ultrazohm/uz_carrierboard/manufacturing reports/PDF/korrekt_bestueckt.jpg

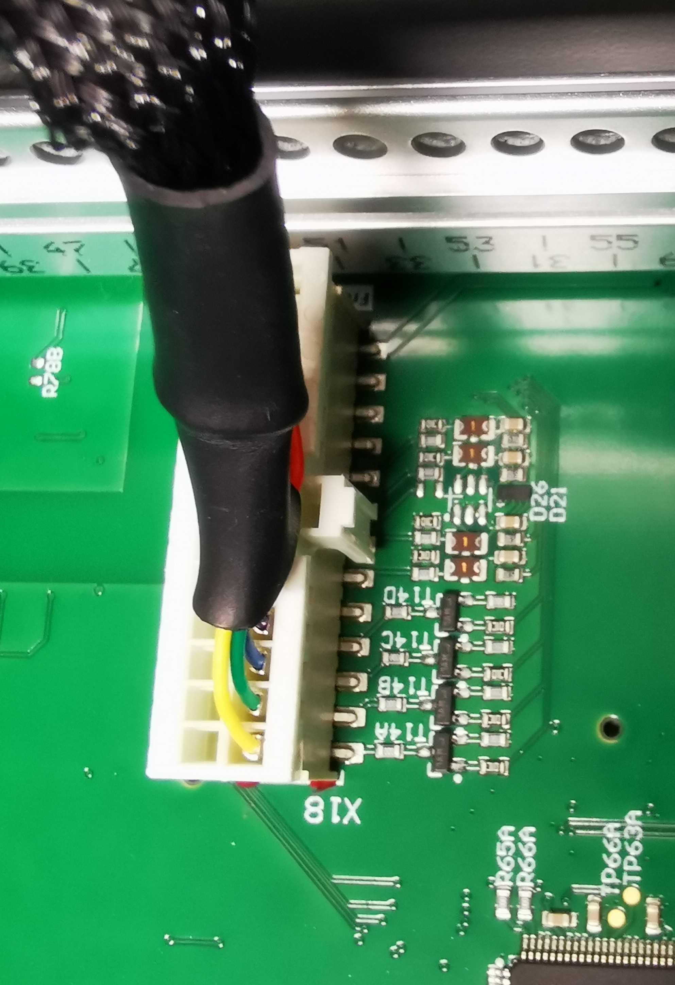
manufacturing reports/PDF/korrekt_bestueckt.jpg
