ultrazohm/uz_carrierboard/bugfix/carrierboardPHYresetfix.docx

Carrier Board PHY reset fix

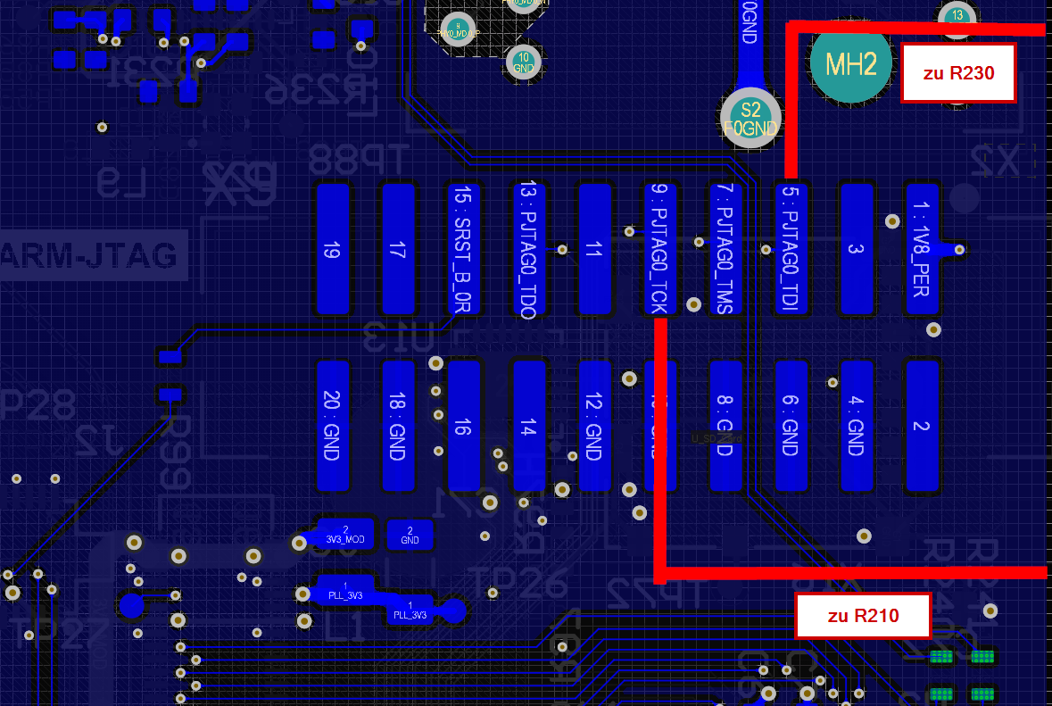
[picture p2: figure]

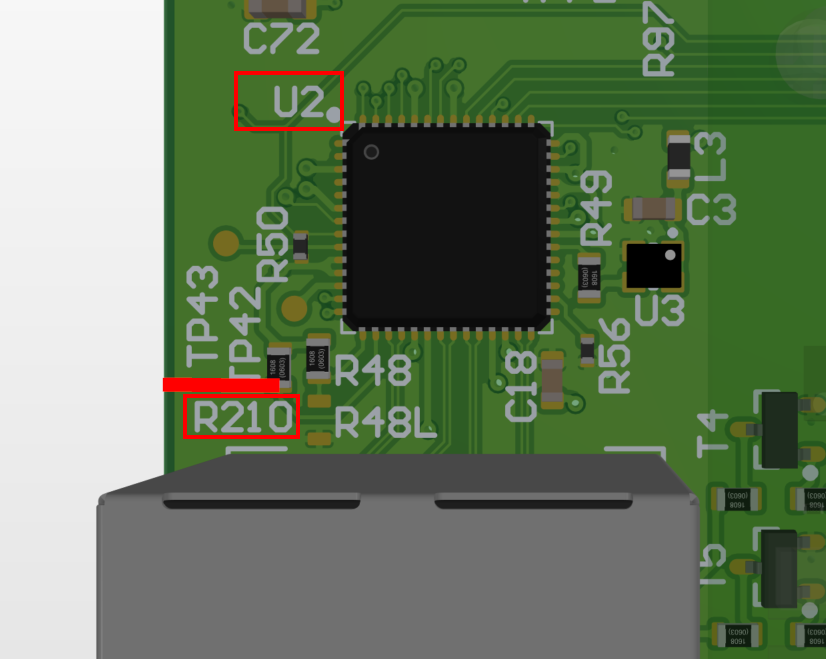
[picture p3: figure]
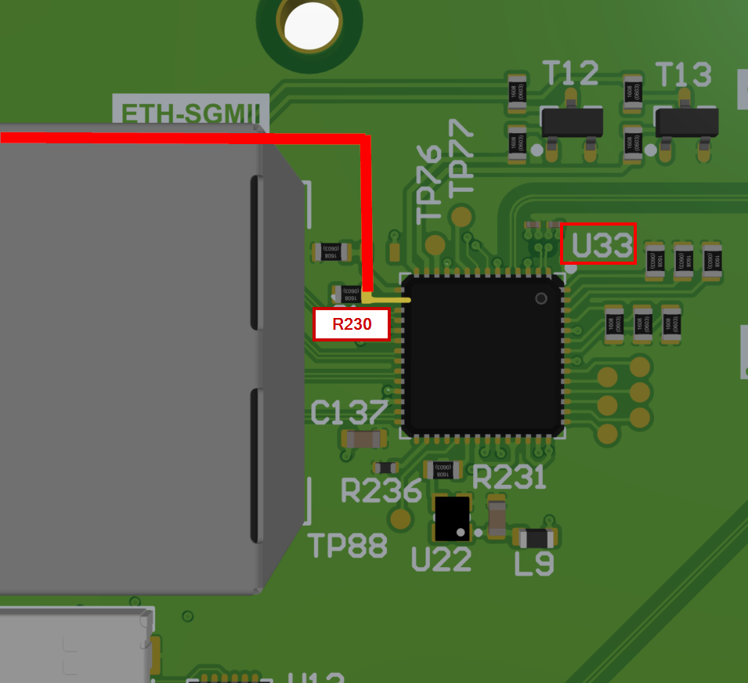
[picture p4: figure]

REPLACE R210 and R230 with 10k !!!
