ultrazohm/uz_carrierboard/Project Outputs for UltraZOhm_CarrierBoard/Rev. 3/BOM/BOM_UltraZOhm_CarrierBoard_3v00_AG1.xls

Sheet: Part List Report
 | Bill of Material |  |  | BOM_Template for Variant [Standard] of Project [UltraZOhm_CarrierBoard.PrjPcb] (No PCB Document Selected)
 | Source Data From: |  | UltraZOhm_CarrierBoard.PrjPcb
 | Project: |  | UltraZOhm_CarrierBoard.PrjPcb
 | Variant: |  | Standard
 | Report Date: |  |  |  | 17.06.2020
 | Print Date: |  |  |  | 2020-06-17
# | Quantity | Comment | Designator | MF | MPN | Voltage | Dielectric | Supplier 1 | Supplier Part Number 1 | Supplier 2 | Supplier Part Number 2 | Supplier 3 | Supplier Part Number 3 | Fabrication Notes
1 | 1 | 22µF | C1 | Multicomp | MC1206X226K160CT | 16V | X5R | Farnell | 2320923
2 | 17 | 470nF | C2, C3, C5, C6, C7, C8, C9, C10, C14, C15, C16, C18, C20, C47, C57, C67, C71 | Kemet | C0603C474K4PACTU | 16V | X5R | Farnell | 2522418
3 | 103 | 100nF | C4, C22A, C22B, C22C, C22D, C22E, C23A, C23B, C23C, C23D, C23E, C24A, C24B, C24C, C24D, C24E, C25A, C25B, C25C, C25D, C25E, C26A, C26B, C26C, C26D, C26E, C27A, C27B, C27C, C27D, C27E, C28A, C28B, C28C, C28D, C28E, C29A, C29B, C29C, C29D, C29E, C30A, C30B, C30C, C30D, C30E, C31A, C31B, C31C, C31D, C31E, C32A, C32B, C32C, C32D, C32E, C33A, C33B, C33C, C33D, C33E, C34A, C34B, C35A, C35B, C38A, C38B, C75, C76, C77, C78, C79, C80, C82, C88, C90, C91, C96, C97, C98, C99, C100, C101, C103, C106A, C106B, C106C, C106D, C106E, C106F, C106G, C106H, C107, C110, C111, C117, C118, C119, C120, C122, C123, C124, C125 | Multicomp | MC0603B104K500CT | 50V | X7R | Farnell | 1759122
4 | 2 | 4.7µF | C11, C13 | Murata | GRT188R61E475KE13D | 25V | X5R | Farnell | 2672159
5 | 1 | 100pF | C12 | Kemet | C1210C101KDGACAUTO | 1000V | C0G / NP0 | Farnell | 2834664
6 | 2 | 10µF | C17, C19 | Murata | GRM188R60J106ME47J | 6.3V | X5R | Farnell | 2611921
7 | 4 | 220nF | C21, C50, C60, C70 | Wuerth Elektronik | 885012206048 | 16V | X7R | Farnell | 2507331 |  |  |  |  | wird beigestellt
8 | 3 | 4.7nF | C36A, C36B, C94 | TDK | C1608C0G1H472J080AA | 50V | C0G / NP0 | Farnell | 1907312
9 | 4 | 1nF | C37A, C37B, C81, C102 | AVX | 06035A102JAT2A | 50V | C0G / NP0 | Farnell | 317202
10 | 4 | 22µF | C39A, C39B, C83, C104 | TDK | C2012X5R1C226M125AC | 16V | X5R | Farnell | 2525135
11 | 4 | 10µF | C40A, C40B, C84, C105 | AVX | 0603ZD106MAT2A | 10V | X5R | Farnell | 1867954
12 | 14 | 10µF | C41, C42, C43, C44, C51, C52, C53, C54, C61, C62, C63, C64, C89, C121 | Murata | GRM21BC8YA106KE11L | 35V | X6S | Farnell | 2611936 | Mouser | 81-GRM21BC8YA106KE1L
13 | 3 | 33nF | C45, C55, C65 | Wuerth Elektronik | 885012206092 | 50V | X7R | Farnell | 2495184 |  |  |  |  | wird beigestellt
14 | 3 | 220µF | C46, C56, C66 | Wuerth Elektronik | 875115350002 | 16V |  | Farnell | 2466695 | Mouser | 710-875115350002 |  |  | wird beigestellt
15 | 6 | 22µF | C48, C49, C58, C59, C68, C69 | Wuerth Elektronik | 885012108018 | 16V | X5R | Mouser | 710-885012108018 |  |  |  |  | wird beigestellt
16 | 3 | 47µF | C72, C92, C93 | Murata | GRM32EC81C476KE15L | 16V | X6S | Farnell | 1907527
17 | 1 | 10µF | C85 | TDK | C2012X7R0J106M125AB | 6.3V |  | Digi-Key | 445-7594-6-ND | Mouser | 810-C2012X7R0J106MAB
18 | 1 | 22µF | C86 | TDK | C2012X7S1A226M125AC | 6.3V |  | Digi-Key | 445-14560-6-ND | Mouser | 810-C2012X7S1A226MAC
19 | 1 | 10nF | C87 | Murata | GRM188R70J103KA01 | 6.3V |  | Digi-Key | 490-9729-1-ND
20 | 1 | 47pF | C95 | Wuerth Elektronik | 885012006055 | 50V | C0G / NP0 | Farnell | 2533852 |  |  |  |  | wird beigestellt
21 | 5 | 100pF | C112, C113, C114, C115, C116 | AVX | 06035A101JAT4A | 50V | C0G / NP0 | Farnell | 499122 | Mouser | 581-06035A101JAT4A, [NoParam] | Digi-Key | 478-10676-1-ND
22 | 6 | 150060RS75000 | D1, D2, D3, D11, D16, D18 | Wuerth Elektronik | 150060RS75000 |  |  | Farnell | 2322071 | Mouser | 710-150060RS75000 | Digi-Key | 732-4978-1-ND | wird beigestellt
23 | 5 | BAT46W | D4A, D4B, D4C, D4D, D4E | Diodes Incorporated | BAT46W-7-F |  |  | Farnell | 1858621 | Mouser | 621-BAT46W-7-F | Digi-Key | BAT46W-7FDICT-ND
24 | 2 | ESDCAN01-2BLY | D5A, D5B | ST Microelectronics | ESDCAN01-2BLY |  |  | Farnell | 2455736 | Mouser | 511-ESDCAN01-2BLY | Digi-Key | 497-15333-1-ND
25 | 8 | BAT20J | D6A, D6B, D7A, D7B, D14, D15, D19, D20 | ST Microelectronics | BAT20JFILM |  |  | Farnell | 1467541
26 | 2 | 150060GS75000 | D10, D25 | Wuerth Elektronik | 150060GS75000 |  |  | Farnell | 2322070 | Mouser | 710-150060GS75000 | Digi-Key | 732-4971-1-ND | wird beigestellt
27 | 5 | 150060BS75000 | D12, D24A, D24B, D24C, D24D | Wuerth Elektronik | 150060BS75000 |  |  | Farnell | 2322069 | Mouser | 710-150060BS75000 | Digi-Key | 732-4966-1-ND | wird beigestellt
28 | 1 | STPS340-Y | D17 | ST Microelectronics | STPS340UY |  |  | Mouser | 511-STPS340UY | Digi-Key | 497-13432-1-ND
29 | 8 | CDSOD323-T03SC | D21A, D21B, D21C, D21D, D21E, D21F, D21G, D21H | Bourns | CDSOD323-T03SC |  |  | Farnell | 2341910 | Mouser | 652-CDSOD323-T03SC | Digi-Key | CDSOD323-T03SCCT-ND
30 | 1 | BZX84C15 | D22 | On Semiconductor | BZX84C15LT1G |  |  | Mouser | 863-BZX84C15LT1G | Digi-Key | BZX84C15LT1GOSCT-ND | Farnell | 1651578
31 | 1 | SMBJ30A, 30V | D23 | Fairchild | SMBJ30A |  |  | Mouser | 512-SMBJ30A
32 | 1 | 5A Fast-Acting Fuse | F1 | Littlefuse | 0154005.DR |  |  | Farnell | 9943668 | Mouser | 576-0154005.DR
33 | 4 | SS5-80-3.50-L-D-K-TR | J1, J2, J3, J4 | SAMTEC | SS5-80-3.50-L-D-K-TR |  |  | Mouser | 200-SS5803.50LDKTR | Digi-Key | SAM15086CT-ND |  |  | wird beigestellt
34 | 1 | 1µH | L1 | Wuerth Elektronik | 74479787210A |  |  | Farnell | 2066866 | Mouser | 710-74479787210A | Digi-Key | 732-3436-1-ND | wird beigestellt
35 | 3 | MPZ1608S221ATA00 | L2, L3, L4 | TDK | MPZ1608S221ATA00 |  |  | Farnell | 1301677 | Mouser | 810-MPZ1608S221ATA00 | Digi-Key | 445-1565-1-ND
36 | 2 | 744235900 | L5A, L5B | Wuerth Elektronik | 744235900 |  |  | Farnell | 2249865 | Mouser | 710-744235900 | Digi-Key | 732-4223-1-ND | wird beigestellt
37 | 5 | 600 Ohm | L6, L7, L8, L9, L11 | Wuerth Elektronik | 742792040 |  |  | Mouser | 710-742792040 | Digi-Key | 732-1620-1-ND |  |  | wird beigestellt
38 | 1 | 1.0µH | L10 | Coilcraft | XFL4020-102MEB |  |  | Mouser | 994-XFL4020-102MEB
39 | 1 | 15µH | L12 | Coilcraft | XAL5050-153MEC |  |  | Mouser | 994-XAL5050-153MEC
40 | 43 | 0R | R1, R15, R16, R26, R27, R48, R65A, R65B, R65C, R65D, R65E, R66A, R66B, R66C, R66D, R66E, R74A, R74B, R74C, R74D, R74E, R99, R132, R168A, R168B, R168C, R168D, R168E, R168F, R168G, R168H, R206, R207, R209, R210, R212, R213, R214, R215, R216, R217, R222, R224 | Multicomp | MCMR06X000 PTL | 75V |  | Farnell | 2073345
41 | 7 | 220 | R2, R4, R6, R52, R53, R142, R147 | Multicomp | MCWR06X2200FTL | 50V |  | Farnell | 2447298
42 | 63 | 10k | R3, R5, R7, R11, R12, R13, R14, R17, R18, R20, R21, R22, R23, R24, R25, R32, R33, R35, R37, R39, R41, R43, R45, R51, R54, R90, R97, R111, R112, R113, R114, R115, R116, R117, R118, R119, R122, R123, R124, R125, R146, R148, R171A, R171B, R171C, R171D, R171E, R171F, R171G, R171H, R175A, R175B, R175C, R175D, R193, R194, R195, R196, R198, R199, R201, R203, R204 | Multicomp | MCWR06X1002FTL | 50V |  | Farnell | 2447230
43 | 2 | 1k | R8, R92 | Yageo, Multicomp | RC0603FR-071KL | 75V |  | Farnell | 9238484
44 | 3 | 100 | R9, R10, R91 | Multicomp | MCWR06X1000FTL | 50V |  | Farnell | 2447227
45 | 12 | 22 | R28A, R28B, R28C, R29A, R29B, R29C, R30A, R30B, R30C, R31A, R31B, R31C | Multicomp | MCWR06X22R0FTL | 50V |  | Farnell | 2447301
46 | 6 | 33 | R49, R71A, R71B, R71C, R71D, R71E | Multicomp | MCWR06X33R0FTL | 50V |  | Farnell | 2447344
47 | 2 | 4k99 | R50, R56 | Multicomp | MCSR06X4991FTL | 75V |  | Farnell | 2074271
48 | 1 | 1M | R55 | ROHM | KTR18EZPF1004 | 500V |  | Farnell | 2802466
49 | 40 | 51 | R57A, R57B, R57C, R57D, R57E, R58A, R58B, R58C, R58D, R58E, R59A, R59B, R59C, R59D, R59E, R60A, R60B, R60C, R60D, R60E, R61A, R61B, R61C, R61D, R61E, R62A, R62B, R62C, R62D, R62E, R63A, R63B, R63C, R63D, R63E, R64A, R64B, R64C, R64D, R64E | Panasonic | EXB-38V510JV |  |  | Mouser | 667-EXB-38V510JV
50 | 34 | 51 | R67A, R67B, R67C, R67D, R67E, R68A, R68B, R68C, R68D, R68E, R69A, R69B, R69C, R69D, R69E, R70A, R70B, R70C, R70D, R70E, R72A, R72B, R72C, R72D, R72E, R73A, R73B, R73C, R73D, R73E, R174A, R174B, R174C, R174D | Multicomp | MCMR06X51R0FTL | 75V |  | Farnell | 2073529
51 | 12 | 62 | R76A, R76B, R77A, R77B, R169A, R169B, R169C, R169D, R169E, R169F, R169G, R169H | Multicomp | MCWR06X62R0FTL | 50V |  | Farnell | 2447415
52 | 2 | 29k4 | R80A, R80B | Vishay | MCWR06X2942FTL | 75V |  | Farnell | 2694813
53 | 4 | 9k31 | R81A, R81B, R127, R164 | Panasonic | ERJ3EKF9311V | 75V |  | Farnell | 2059405
54 | 2 | 4k7 | R82, R86 | Multicomp | MCWR04X4701FTL | 50V |  | Farnell | 2447187
55 | 3 | 1k5 | R83, R87, R93 | Multicomp | MCWR06X1501FTL | 50V |  | Farnell | 2447279
56 | 6 | 47k | R88, R95, R172, R173, R219, R220 | Multicomp Pro | MCWR04X4702FTL | 50V, 50 |  | Farnell | 2447179
57 | 1 | 1k91 | R94 | Panasonic | ERA3ARB1911V | 75V |  | Farnell | 2094529
58 | 1 | 16k | R126 | Vishay | CRCW060316K0FKEA | 75V |  | Farnell | 2138433
59 | 7 | 0R | R128, R129, R130, R131, R133, R136, R139 | Multicomp | MCMR12X000 PTL |  |  | Farnell | 2073874
60 | 1 | 100k | R134 | Vishay | CRCW0603100KFKEA | 75V |  | Farnell | 1469649
61 | 1 | 24k9 | R135 | Vishay | CRCW060324K9FKEA | 75V |  | Farnell | 1469785
62 | 3 | 20k | R137, R140, R143 | Bourns | CR0603-FX-2002ELF | 50V |  | Farnell | 2333523
63 | 1 | 2k | R141 | Multicomp | MCWR06X2001FTL | 50V |  | Farnell | 2447319
64 | 1 | 1k6 | R144 | Panasonic | ERJ3EKF1601V | 75V |  | Farnell | 2303159
65 | 1 | 412k | R145 | Panasonic | ERJ3EKF4123V | 75V |  | Farnell | 2303283
66 | 8 | 6 | R170A, R170B, R170C, R170D, R170E, R170F, R170G, R170H | Bel Fuse | 0ZCK0010FF2G |  |  | Mouser | 530-0ZCK0010FF2G
67 | 4 | 200k | R192, R211, R218, R225 | Multicomp | MCWR06X2003FTL | 50V |  | Farnell | 2447291
68 | 1 | 100 | R197 | Multicomp | MCMR06X51R0FTL | 75V |  | Farnell | 2073347
69 | 3 | DIP Switch | SW1, SW2, SW3 | TE Connectivity | 1571983-5 |  |  | Farnell | 2060778 | Mouser | 506-GDH04STR04 | Digi-Key | 450-1762-1-ND
70 | 12 | MMBT3904 | T1, T2, T3, T4, T5, T6, T7, T9A, T9B, T9C, T9D, T10 | Diodes Incorporated | MMBT3904-7-F |  |  | Farnell | 1773602 | Mouser | 621-MMBT3904-F | Digi-Key | MMBT3904-FDICT-ND
71 | 2 | ATP108-TL-H | T8, T11 | On Semiconductor | ATP108-TL-H |  |  | Mouser | 863-ATP108-TL-H | Farnell | 2774816RL | Digi-Key | ATP108-TL-HOSCT-ND
72 | 1 | SiT8924, 4 MHz | U1 | SiTime | SIT8924AM-12-33N-4.000000G | 3.3V |  | Digi-Key | 1473-1689-1-ND
73 | 1 | 88E1512-A0-NNP2I000 | U2 | Marvell | 88E1512-A0-NNP2I000 |  |  | Mouser | 348-88E1512A0NNP2I00
74 | 1 | SiT8008, 25 MHz | U3 | SiTime | SIT8008BI-73-18S-25.000000G | 1.8V |  | Mouser | 788-8008BI7318S25.G | Digi-Key | SIT8008BI-73-18S-25.000000G
75 | 5 | LA4128V-75TN100E | U4A, U4B, U4C, U4D, U4E | Lattice | LA4128V-75TN100E |  |  | Mouser | 842-LA4128V75TN100E | Digi-Key | LA4128V-75TN100E-ND
76 | 5 | 74AHC1G14GW,125 | U5A, U5B, U5C, U5D, U5E | Nexperia | 74AHC1G14GW,125 |  |  | Digi-Key | 1727-3149-2-ND | Mouser | 771-74AHC1G14GW-G | Farnell | 2336684
77 | 2 | MAX14878 | U6A, U6B | Maxim Integrated | MAX14878AWE+ |  |  | Farnell | 2792798 | Mouser | 700-MAX14878AWE+ | Digi-Key | MAX14878AWE+-ND
78 | 4 | LT1761-BYP | U7A, U7B, U19, U27 | Linear Technology | LT1761ES5-BYP#TRMPBF |  |  | Farnell | 1663782
79 | 4 | 760390015 | U8A, U8B, U20, U28 | Wuerth Elektronik | 760390015 |  |  | Mouser | 710-760390015 | Digi-Key | 732-4459-1-ND |  |  | wird beigestellt
80 | 4 | SN6505BDBVT | U9A, U9B, U21, U29 | Texas Instruments | SN6505BDBVT |  |  | Farnell | 2507108
81 | 3 | 171050601 | U10, U11, U12 | Wuerth Elektronik | 171050601 |  |  | Mouser | 710-171050601 |  |  |  |  | wird beigestellt
82 | 1 | TXS02612RTWR | U13 | Texas Instruments | TXS02612RTWR |  |  | Farnell | 2335617RL | Mouser | 595-TXS02612RTWR | Digi-Key | 296-23869-1-ND
83 | 3 | TXS0108EQPWRQ1 | U14_new, U25_new, U30_new | Texas Instruments | TXS0108EQPWRQ1 |  |  | Mouser | 595-TXS0108EQPWRQ1 | RS | 709-4639 | Digi-Key | 296-23011-1-ND
84 | 2 | 74HC32A | U15, U16 | ON Semiconductor | NLV74HC32ADTR2G |  |  | Mouser | 863-NLV74HC32ADTR2G | Digi-Key | NLV74HC32ADTR2GOSCT-ND
85 | 2 | SN74AVC4T774 | U17, U31 | Texas Instruments | SN74AVC4T774RSVR |  |  | Mouser | 595-SN74AVC4T774RSVR
86 | 1 | ADUM4401 | U18 | Analog Devices | ADUM4401ARWZ |  |  | Mouser | 584-ADUM4401ARWZ-R | Newark | 11R0965
87 | 1 | TPS62097-Q1 | U22 | Texas Instruments | TPS62097QWRGTRQ1 |  |  | Farnell | 2851313 | Mouser | 595-TPS62097QWRGTRQ1 | Digi-Key | 296-48349-1-ND
88 | 1 | TPS54260-Q1 | U23 | Texas Instruments | TPS54260QDGQRQ1 |  |  | Mouser | 595-TPS54260QDGQRQ1 | Digi-Key | 296-28183-1-ND
89 | 2 | ADUM4402 | U24, U26 | Analog Devices | ADUM4402WARWZ |  |  | Mouser | 584-ADUM4402WARWZ
90 | 1 | LMK00105 | U32 | Texas Instruments | LMK00105SQ/NOPB |  |  | Farnell | 2492236 | Mouser | 926-LMK00105SQ/NOPB | Digi-Key | 296-35192-1-ND
91 | 2 | TE0790-Base | X1, X8 | Trenz Electronic | TE0790-02 |  |  | Trenz Electronic | TE0790-02 | Digi-Key | 1686-1023-ND |  |  | zwei-reihige Stiftleisten einlöten
92 | 1 | IPL1-110-02-L-D-K | X3 | SAMTEC | IPL1-110-02-L-D-K |  |  | Farnell | 2779506 | Mouser | 200-IPL111002LDK | Digi-Key | SAM10586-ND | wird beigestellt
93 | 1 | 7499110123 | X4 | Wuerth Elektronik | 7499110123 |  |  | Farnell | 2356117 | Mouser | 710-7499110123 | Digi-Key | 732-4958-ND | wird beigestellt
94 | 3 | HSEC8-140-01-L-DV-A-BL | X5A, X5B, X5C | SAMTEC | HSEC8-140-01-L-DV-A-BL |  |  | Farnell | 2731769 | Mouser | 200-HSEC814001LDVABL | Digi-Key | HSEC8-140-01-L-DV-A-BL-ND | wird beigestellt
95 | 5 | HSEC8-150-01-L-DV-A-BL | X6A, X6B, X6C, X6D, X6E | SAMTEC | HSEC8-150-01-L-DV-A-BL |  |  | Farnell | 2731836 | Mouser | 200-HSEC815001LDVABL | Digi-Key | HSEC8-150-01-L-DV-A-BL-ND | wird beigestellt
96 | 2 | IPL1-104-01-L-S-K | X7A, X7B | SAMTEC | IPL1-104-01-L-S-K |  |  | Farnell | 2856253 | Mouser | 200-IPL110401LSK | Digi-Key | SAM9098-ND | wird beigestellt
97 | 1 | IPL1-106-02-L-D-K | X10 | SAMTEC | IPL1-106-02-L-D-K |  |  | Mouser | 200-IPL110602LDK | Digi-Key | SAM10584-ND |  |  | wird beigestellt
98 | 1 | IPL1-103-01-L-D-K | X12 | SAMTEC | IPL1-103-01-L-D-K |  |  | Farnell | 2856248 | Mouser | 200-IPL110301LDK | Digi-Key | SAM9594-ND | wird beigestellt
99 | 1 | IPL1-108-01-L-D-K | X13 | SAMTEC | IPL1-108-01-L-D-K |  |  | Farnell | 2856261 | Mouser | 200-IPL110801LDK | Digi-Key | SAM10585-ND | wird beigestellt
100 | 1 | IPL1-105-01-L-D-K | X14 | SAMTEC | IPL1-105-01-L-D-K |  |  | Farnell | 2308545 | Mouser | 200-IPL110501LDK | Digi-Key | SAM8825-ND | wird beigestellt
101 | 1 | IPL1-102-01-L-D-K | X15 | SAMTEC | IPL1-102-01-L-D-K |  |  | Farnell | 2667420 | Mouser | 200-IPL110201LDK | Digi-Key | SAM10565-ND | wird beigestellt
102 | 1 | microSD Memory Card Connector with Detec | X16 | Molex | 104031-0811 |  |  | Farnell | 2466891 | Mouser | 538-104031-0811 | Digi-Key | WM6357CT-ND
Total: | 593

Sheet: Project Information
Project Full Path | D:\Work_Altium\UltraZohm_CarrierBoard\UltraZohm_CarrierBoard\UltraZOhm_CarrierBoard.PrjPcb
Project Filename | UltraZOhm_CarrierBoard.PrjPcb
Variant Name | Standard
Data-Source Filename | UltraZOhm_CarrierBoard.PrjPcb
Data-Source Full Path | D:\Work_Altium\UltraZohm_CarrierBoard\UltraZohm_CarrierBoard\UltraZOhm_CarrierBoard.PrjPcb
Title | BOM_Template for Variant [Standard] of Project [UltraZOhm_CarrierBoard.PrjPcb] (No PCB Document Selected)
Total Quantity | 594
Report Time | 11:21
Report Date | 17.06.2020
Report Date & Tine | 17.06.2020 11:21
Output Name | BOM_Template
Output Type | BOM_PartType
Output Generator Name | BOM
Output Generator Description | Bill of Materials
