ultrazohm/uz_carrierboard/manufacturing reports/BOM/BOM_xlsx-S001_fix.xlsx

Designator | AN | Comment | Description
R168 | 21491 | 0R | WID SMD 0R 0,1W 1% TK100 BF 1608 (0603)
R169 | 25938 | 51R | WID SMD 51R 1% 0,1W BF 1608 (0603)
R170 | 28044 | PPTC 0,1A 15V | PTC Resettable Fuse 0.1A 15V SMD 0805
R171 | 21492 | 10K | WID SMD 10K 1% 0,1W BF 1608 (0603)
C106 | 21382 | 100nF | KON 100nF 50V X7R ±10% SMD BF 1608 (0603)
