ultrazohm/uz_carrierboard/manufacturing reports/BOM/BOM_xlsx-S001_additional_costs.xlsx

Beistellungen Carrierboard Rev04
AN | Quantity | Designator | Comment | Preis per Part (ca.) | Preis | Source | Währung | Bestellung
31505 | 2 | U14, U30 | (cs) TXS0108EQPWRQ1 | 5.12 € | 10.24 € | win-source | USD | Order #227370
31971 | 2 | U23A, U23B | (cs) TPS54260DGQR | 1.24 € | 2.48 € | LCSC | USD
31504 | 5 | U17, U25A, U25B, U25C, U31 | (cs) SN74AVC4T774RSVR | 0.56 € | 2.78 € | TI | EUR
31885 | 5 | U4A, U4B, U4C, U4D, U4E | (cs) LC4256V-75TN100C | 23.86 € | 119.30 € | Schukat | EUR
31527 | 3 | U24A, U24B, U24C | (cs) ADUM4402BRWZ | 5.91 € | 17.73 € | RS | EUR
31526 | 1 | U18 | (cs) ADUM4401ARWZ | 5.19 € | 5.19 € | RS | EUR
(handbestückt) | 4 | U9A, U9B, U21, U29 | SN6501DBVR | 8.23 € | 32.92 € | win-source | USD | Order #227370
 | 1 |  | win-source shipping | 5.00 € | 5.00 € | win-source | USD | Order #227370
 |  |  | Summe pro Carrier |  | 195.63 €
 |  |  | Anzahl Carrierboards | 10 | 1956.35 €
