ultrazohm/uz_carrierboard/Simulation/FrontPanel_LEDs/UZ_CB_LEDdrive.asc

D1: LED
Q1: npn; Fairchild_2N3904
R1: res; 100
V1: voltage; 24
V2: voltage; PULSE(0 1.8 10m 1u 1u 50m 0.1)
Named nets: 0
.model Fairchild_2N3904 NPN(Is=6.734f Xti=3 Eg=1.11 Vaf=74.03 Bf=416.4 Ne=1.259 Ise=6.734 Ikf=66.78m Xtb=1.5 Br=.7371 Nc=2 Isc=0 Ikr=0 Rc=1 Cjc=3.638p Mjc=.3085 Vjc=.75 Fc=.5 Cje=4.493p Mje=.2593 Vje=.75 Tr=239.5n Tf=301.2p Itf=.4 Vtf=4 Xtf=2 Rb=10)
.tran 0 70m 0 1u
Driving front panel LEDs
flexible driving 
voltage:
3.3V    or    24V
