ultrazohm/uz_carrierboard/Simulation/PowerSupply_Input_v4/strombegrenzung_cb_dmp4015sss.asc

C1: cap; 100n
C2: cap; 10µ
C3: cap; 500µ
C4: cap; 100n
C5: cap; 10µ
C6: cap; 500µ
D1: diode
R1: res; 47k
R3: res; 47k
R4: res; 47k
R5: res; 47k
R6: res; 10m
R8: res; 47k
R9: res; 47k
R10: res; 47k
R11: res; 47k
R12: res; 10m
Rout_new: res; 5
Rout_old: res; 5
U1: DMP4015SSS
U2: DMP4015SSS
U3: DI_MMSZ5242B
U4: atp108
U5: atp108
V1: voltage; PULSE(0 24 10m 1u 1u 1 2)
V2: voltage; PULSE(0 24 10m 1u 1u 1 2)
Named nets: S1, G, 0, S2, D_U1, S_U1, S_U2, D_U2, G_U2, G_U1, S_U4, D_U4, G_U4, D_U5, S_U5, G_U5
.tran 0 140m 0 1u
.include atp108_rev0.lib
new version: 
(due to usage of Trenz library)
old version:
