ultrazohm/uz_carrierboard/(list of files, drawings)

Other design files:
Analog_Interface.SchDoc
ANL_P54_Buffer.SchDoc
Backpanel.SchDoc
Backpanel_GigIO.SchDoc
Backpanel_SwapMGT4.SchDoc
Block_Diagram.SchDoc
Block_Diagram_Safety.SchDoc
CarrierBoard_TopSheet.SchDoc
DIG_S3C_MultiChannelFunnel.SchDoc
Digital_Interface.SchDoc
ETH-PHY.SchDoc
ETH-PHY_SGMII_TI.SchDoc
Frontpanel.SchDoc
GTH.SchDoc
I2C0_Mux.SchDoc
I2C_Subsystems.SchDoc
isoDebug-Isolation.SchDoc
J1-3xGTHQ_R+B66.SchDoc
J2-1xGTHQ_L+1xGTHCLK+GTRQ+2xGTRCLK+4xPLLCLK+CFG+STAT.SchDoc
J2_RefClkAndRTC.SchDoc
J3-3xGTHCLK+1xPLLCLK+MIO+B47+B48.SchDoc
J4-B64+B65.SchDoc
LevelShiftingExtGPIO.SchDoc
Power_Supply_1.SchDoc
Power_Supply_2.SchDoc
Power_Supply_Input.SchDoc
Rail_Protection_AD.SchDoc
Rail_Protection_BP.SchDoc
Rail_Shutdown_AD.SchDoc
Rev05MergeRedux--External_IO_Protection.SchDoc
Rev05MergeRedux--LED_external.SchDoc
Rev05MergeRedux--LevelShifting_Isolation.SchDoc
S3C.SchDoc
S3C_FrontpanelInterface.SchDoc
S3C_IOs1V8.SchDoc
S3C_IOs3V3.SchDoc
S3C_SplitSPI.SchDoc
S3C_SupplyAndMonitoring.SchDoc
SD_Card.SchDoc
Signal_Distribution.SchDoc
SoM.SchDoc
Switch_External.SchDoc
User_Connectors.SchDoc
UZ_CarrierBoard.PcbDoc
UZ_CarrierBoard.PrjPcb
UZ_CarrierBoard/UZ_CarrierBoard.SCHLIB
