ultrazohm/uz_carrierboard/(commit log)

2019-11-09 First Initialization. UltraZohm_CarrierBoard_2v00 was the final assembled version.
    [Analog_Interface.SchDoc, BOM_UltraZOhm_CarrierBoard_2v00.xls, BOM_UltraZOhm_CarrierBoard_2v00_AG_v1.xlsx, Block_Diagram.SchDoc, Board2Board.SchDoc, CarrierBoard_TopSheet.SchDoc, Collective_FAULT_logic.SchDoc, DiagLEDs.SchDoc]
2020-05-30 removed project outputs from git tracking
    Added gitignore that ignores the History __Preview project logs and project outputs
    [BOM_UltraZOhm_CarrierBoard_2v00.xls, BOM_UltraZOhm_CarrierBoard_2v00_AG_v1.xlsx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]
2020-05-30 Renamed PL_ANL_GPIO_01 to CS_fastADC_02 and CS_fastADC to CS_fastADC_01 on all sheets. Distributed unidirectional and bidirectional level shifiting of U30 and U31 to 2 different sheets
    [Analog_Interface.SchDoc, Board2Board.SchDoc, CarrierBoard_TopSheet.SchDoc, LevelShifting.SchDoc, Signal_Distribution.SchDoc, UltraZOhm_CarrierBoard.PrjPcb, UnidirectionalLevelShifiting.SchDoc]
2020-05-30 Refactored project and removed errors and warning by placing appropriate symbols that match a 100mil grid and by placing no ERC symbols
    [Analog_Interface.SchDoc, BidirectionalLevelShifting.SchDoc, Block_Diagram.SchDoc, Board2Board.SchDoc, Collective_FAULT_logic.SchDoc, Collective_FAULT_logic_new.SchDoc, Digital_Interface.SchDoc, J1.SchDoc]
2020-05-30 Added carrier board and samtec libraries and added new U30 chip in the layout.
    Added termination resistors to outputs of U31 and routet individual traces from U31 to all sockets.
    connected U30 and U31
    Connected 1V8 I2C bus to digital pins
    [Analog_Interface.SchDoc, BidirectionalLevelShifting.SchDoc, CarrierBoard_TopSheet.SchDoc, Signal_Distribution.SchDoc, UltraZOhm_CarrierBoard.PrjPcb, UnidirectionalLevelShifiting.SchDoc]
2020-05-30 Routing of U30 and U31 is finished. Top overlay still needs to be adapted. Fixes #12
    [UltraZOhm_CarrierBoard.PrjPcb]
2020-05-30 Changed description of revision and date on the PCB
    [UltraZOhm_CarrierBoard.PrjPcb]
2020-05-30 Replaced CPLD jumpers by 0 ohm resistors and added U25_new
    [LevelShifting.SchDoc, LevelShiftingExtGPIO.SchDoc, Signal_Distribution.SchDoc, UltraZOhm_CarrierBoard.PrjPcb, isoGPIO.SchDoc]
2020-05-30 Found a bug in LSF symbol definition. Fixed it and rerouted the wrong traces.
    [LevelShifting.SchDoc, LevelShiftingExtGPIO.SchDoc, UltraZOhm_CarrierBoard.PrjPcb]
2020-05-30 Routed U25_old and U25_new. Fixes #14 and #19
    [LevelShiftingExtGPIO.SchDoc]
2020-05-30 Replaced jumpers on CPLD programming traces with 0 ohm resistors. Fixes #4
    [LevelShiftingExtGPIO.SchDoc, Signal_Distribution.SchDoc, UltraZOhm_CarrierBoard.PrjPcb]
2020-05-30 Added input current limitation and GND plane on bottom side. Fixes #15
    [Power_Supply_Input.SchDoc, UltraZOhm_CarrierBoard.PrjPcb]
2020-05-30 Added RC delay circuits to power supplies. Fixes #10
    [BidirectionalLevelShifting.SchDoc, Power_Supply_1.SchDoc, UltraZOhm_CarrierBoard.PrjPcb, UnidirectionalLevelShifiting.SchDoc]
2020-06-02 Updated Top Overlay and assembly variants
    [LevelShifting.SchDoc, LevelShiftingExtGPIO.SchDoc, UltraZOhm_CarrierBoard.PrjPcb]
2020-06-02 Removed traces from under U24 and U26. Fixes #24
2020-06-02 Adapted voltage devider on power supply input. Fixes #10
    Modified RC values at U11 and U12.
    [Power_Supply_1.SchDoc, Power_Supply_Input.SchDoc, UltraZOhm_CarrierBoard.PrjPcb]
2020-06-03 Reworked assembly drawing
    [LevelShifting.SchDoc, LevelShiftingExtGPIO.SchDoc]
2020-06-03 Fixed designators on schematic pages and ground polygons on bottom layer
    [LevelShifting.SchDoc, LevelShiftingExtGPIO.SchDoc, Signal_Distribution.SchDoc, isoGPIO.SchDoc]
2020-06-03 Removed comment on isoCAN page and renamed component classes and rooms for the level shifters in layout
    [isoCAN.SchDoc]
2020-06-03 Added U14_new (TXS instead of LSF level shifter) and changed enable of the level shifters to 3V3 enable
    [LevelShifting.SchDoc, LevelShiftingExtGPIO.SchDoc, LevelShiftingXMOD.SchDoc, UltraZOhm_CarrierBoard.PrjPcb, XMOD.SchDoc]
2020-06-03 Added description of the RC circuuit to PowerSupply1 sheet.
    [Power_Supply_1.SchDoc]
2020-06-03 Changed comment of TXS level shifters to TXS0108EQPWRQ1 which determines the automotiv grade variant.
    [LevelShifting.SchDoc, LevelShiftingExtGPIO.SchDoc, LevelShiftingXMOD.SchDoc]
2020-06-04 Added active BOM doc and added suggestions from Andreas to the layout.
    [Collective_FAULT_logic.SchDoc, J2.SchDoc, LevelShiftingXMOD.SchDoc, Power_Supply_Input.SchDoc, UltraZOhm_CarrierBoard.PrjPcb]
2020-06-05 Added teardrops and reworked assembly drawing.
2020-06-05 Straightend trace PS_3V3_GPIO2 at C120
2020-06-06 Untented R144 and added GND Polygons to isolated interfaces on top layer
    [UltraZOhm_CarrierBoard.PrjPcb]
2020-06-06 Tented some more vias that are next to pads. Chose nominal and not least pitch for U14 U25 and U30. Generated Gerber and drill files
    [BOM_UltraZOhm_CarrierBoard_2v00.xls, BOM_UltraZOhm_CarrierBoard_2v00_AG_v1.xlsx, LevelShifting.SchDoc, LevelShiftingExtGPIO.SchDoc, LevelShiftingXMOD.SchDoc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]
2020-06-06 Removed copper from holes in isolated area and regenerated gerber files
    [UltraZOhm_CarrierBoard.PrjPcb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]
2020-07-14 Fabrication Output files modified Configuration of "DNP" in schematics
    [BOM_UltraZOhm_CarrierBoard_3v00.xls, BOM_UltraZOhm_CarrierBoard_3v00_AG1.xls, Board2Board.SchDoc, LevelShifting.SchDoc, LevelShiftingExtGPIO.SchDoc, LevelShiftingXMOD.SchDoc, Power_Supply_1.SchDoc, Power_Supply_2.SchDoc]
2020-10-22 organized schematics new with signal harness and deleted U25_old and replaced U25_new with a better schematic symbol
    [Analog_Interface.SchDoc, Block_Diagram.SchDoc, Board2Board.SchDoc, CarrierBoard_TopSheet.SchDoc, Collective_FAULT_logic.SchDoc, Collective_FAULT_logic_new.SchDoc, DiagLEDs.SchDoc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]
2020-11-04 Signal busses (all DIG and ANL signals to the sockets) start now indexing by 0
    [Analog_Interface.SchDoc, Board2Board.SchDoc, CarrierBoard_TopSheet.SchDoc, Digital_Interface.SchDoc, Signal_Distribution.SchDoc]
2020-11-09 changed 0R R_0603 resistors to 21491 out of TE.DbLib/R_1608_0603
    [Digital_Interface.SchDoc, ETH-PHY.SchDoc, External_IO_Protection.SchDoc, J1.SchDoc, J2.SchDoc, J4.SchDoc, UltraZOhm_CarrierBoard.PrjPcb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]
2020-11-10 changed another 0R R_0603 resistors (R212 to R224) to 21491
    [Power_Supply_1.SchDoc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]
2020-11-10 changed 0R R_1206 resistors to 25896 out of TE.DbLib/R_3216_1206
    [Power_Supply_2.SchDoc, UltraZOhm_CarrierBoard.PrjPcb]
2020-11-10 changed 10k R_0603 resistors to 21492 out of TE.DbLib/R_1608_0603
    [Collective_FAULT_logic.SchDoc, DiagLEDs.SchDoc, ETH-PHY.SchDoc, External_IO_Protection.SchDoc, J2.SchDoc, Pilot_Line.SchDoc, Power_Supply_1.SchDoc, Power_Supply_2.SchDoc]
2020-11-10 changed SS5-80-3.50-L-D-K-TR sockets to 27219 out of TE.DbLib/CON_B2B
    [J1.SchDoc, J3.SchDoc, J4.SchDoc, UltraZOhm_CarrierBoard.PrjPcb]
2020-11-10 changed SN74AVC4T774 (U31) to 27170 out of TE.DbLib/IF
    [LevelShifting.SchDoc, UltraZOhm_CarrierBoard.PrjPcb]
2020-11-10 changed LT1761-BYP (U7) to 29933 out of TE.DbLib/LREG
    [isoCAN.SchDoc]
2020-11-10 changed U17 (SN74AVC4T774 -> 27170), U19 and U27 (LT1761-BYP -> 29933)
    [UltraZOhm_CarrierBoard.PrjPcb, isoGPIO.SchDoc, isoSPI.SchDoc]
2020-11-10 changed TPS54260-Q1 (U23) to 26100 out of TE.DbLib/A_DCDC
    [Power_Supply_2.SchDoc, UltraZOhm_CarrierBoard.PrjPcb]
2020-11-10 changed WE-DCDC-171050601 (Power_Supply_1.SchDoc) to 26051 out of TE.DbLib/DCDC
    [Power_Supply_1.SchDoc]
2020-11-16 changed 1k R_0603 resistors to 21375 out of TE.DbLib/R_1608_0603 and 16k R_0603 resistors to 22630 out of TE.DbLib/R_1608_0603
    [J2.SchDoc, Power_Supply_1.SchDoc, UltraZOhm_CarrierBoard.PrjPcb, isoGPIO.SchDoc, isoSPI.SchDoc]
2020-11-16 changed 22r R_0603 resistors to 21518 out of TE.DbLib/R_1608_0603, 33r R_0603 resistors to 22430 out of TE.DbLib/R_1608_0603, 220r R_0603 resistors to 22324 out of TE.DbLib/R_1608_0603
    [Analog_Interface.SchDoc, Digital_Interface.SchDoc, ETH-PHY.SchDoc, J2.SchDoc, Power_Supply_2.SchDoc, UltraZOhm_CarrierBoard.PrjPcb]
2020-11-16 changed 20k R_0603 resistors to 26112 out of TE.DbLib/A_R_1608_0603, 47k R_0603 resistors to 22428 out of TE.DbLib/R_1608_0603, 51r R_0603 resistors to 25938 out of TE.DbLib/R_1608_0603, modified lay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
    [DiagLEDs.SchDoc, Digital_Interface.SchDoc, Power_Supply_1.SchDoc, Power_Supply_2.SchDoc, Power_Supply_Input.SchDoc, UltraZOhm_CarrierBoard.PrjPcb]
2020-11-16 changed 10uF C_0603 capacitors to 22918 out of TE.DbLib/C_1608_0603, 10uF C_0805 capacitors to 30144 out of TE.DbLib/C_2012_0805
    [ETH-PHY.SchDoc, Power_Supply_1.SchDoc, Power_Supply_2.SchDoc, Power_Supply_Input.SchDoc, UltraZOhm_CarrierBoard.PrjPcb, isoCAN.SchDoc, isoGPIO.SchDoc, isoSPI.SchDoc]
2020-11-16 changed 100nF C_0603 capacitors to 21382 out of TE.DbLib/C_1608_0603
    [Collective_FAULT_logic.SchDoc, Digital_Interface.SchDoc, ETH-PHY.SchDoc, External_IO_Protection.SchDoc, LevelShifting.SchDoc, LevelShiftingExtGPIO.SchDoc, LevelShiftingXMOD.SchDoc, PickPlace_UltraZOhm_CarrierBoard_4v00.csv]
2020-11-16 changed 1nF C_0603 capacitors to 22523 out of TE.DbLib/C_1608_0603, 4.7nF C_0603 capacitors to 29638 out of TE.DbLib/C_1608_0603, 4.7uF C_0603 capacitors to 29699 out of TE.DbLib/C_1608_0603, 20k R_0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
    [ETH-PHY.SchDoc, Power_Supply_2.SchDoc, UltraZOhm_CarrierBoard.PrjPcb, isoCAN.SchDoc, isoGPIO.SchDoc, isoSPI.SchDoc]
2020-11-16 changed 100r R_0603 resistors to 21380 out of TE.DbLib/R_1608_0603, 1k5 R_0603 resistors to 21514 out of TE.DbLib/R_1608_0603, 1k6 R_0603 (R144) to 26104 out of TE.DbLib/A_R_1608_0603
    [J2.SchDoc, Power_Supply_1.SchDoc, Power_Supply_2.SchDoc, UltraZOhm_CarrierBoard.PrjPcb]
2020-11-17 changed 10nF C_0603_X7R (C87) to 23774 out of TE.DbLib/C_1608_0603, 33nF C_0603 capacitors to 23923 out of TE.DbLib/C_1608_0603, 22uF C_0805 capacitors to 29556 out of TE.DbLib/C_2012_0805, 22uF C_12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
    [J3.SchDoc, Power_Supply_1.SchDoc, Power_Supply_2.SchDoc, UltraZOhm_CarrierBoard.PrjPcb, isoCAN.SchDoc, isoGPIO.SchDoc, isoSPI.SchDoc]
2020-11-17 changed 47uF C_1210 capacitors to 22831 out of TE.DbLib/C_3225_1210, 47pF C_0603 (C95) to 25942 out of TE.DbLib/C_1608_0603, 220nF C_0603 capacitors to 29694 out of TE.DbLib/C_1608_0603, 470nF C_0603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
    [ETH-PHY.SchDoc, Power_Supply_1.SchDoc, Power_Supply_2.SchDoc, SD_Card.SchDoc, UltraZOhm_CarrierBoard.PrjPcb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]
2020-11-17 changed 100pF C_0603 capacitors to 21381 out of TE.DbLib/C_1608_0603, 100pF C_1210 (C12) to 22679 out of TE.DbLib/C_3216_1206, 15uH L_Coilkraft_XAL5050 (L12) to 26235 out of TE.DbLib/A_L_SMD, 1uH L_1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
    [ETH-PHY.SchDoc, J3.SchDoc, Power_Supply_2.SchDoc, UltraZOhm_CarrierBoard.PrjPcb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]
2020-11-17 changed 4k7 R_0603 resistors to 21378 out of TE.DbLib/R_1608_0603, 2k R_0603 (R141) to 26105 out of TE.DbLib/A_R_1608_0603, 1M R_1206 (R55) to 22757 out of TE.DbLib/R_3216_1206, 29k4 R_0603 (R80) to 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
    [ETH-PHY.SchDoc, Power_Supply_1.SchDoc, Power_Supply_2.SchDoc, UltraZOhm_CarrierBoard.PrjPcb, isoCAN.SchDoc]
2020-11-17 changed 600Ohm WE-CBF 742792040 to 24513 out of TE.DbLib/L_2012_0805
    [Power_Supply_1.SchDoc, Power_Supply_2.SchDoc, UltraZOhm_CarrierBoard.PrjPcb]
2020-11-17 changed 88E1512-A0-NNP21000 (U2A,U2B,U2C) to 24652 out of TE.DbLib/IF
    [ETH-PHY.SchDoc]
2020-11-17 changed Testpoint 1mm TP_1mm to 25063 out of TE.DbLib/PCB
    [Analog_Interface.SchDoc, Collective_FAULT_logic.SchDoc, Digital_Interface.SchDoc, ETH-PHY.SchDoc, J2.SchDoc, J3.SchDoc, Pilot_Line.SchDoc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]
2020-11-17 changed TE0790-Base TE0790-JB (X1,X8) to 26694 out of TE.DbLib/BLOCKS, microSD Memory Card Connector with Detec 104031-0811 to 26322 out of TE.DbLib/SOCKET, MMBT3904 NPN-SOT23 transistors to 23806 ou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
    [DiagLEDs.SchDoc, ETH-PHY.SchDoc, J2.SchDoc, Power_Supply_2.SchDoc, SD_Card.SchDoc, UltraZOhm_CarrierBoard.PrjPcb, XMOD.SchDoc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]
2020-11-17 changed TXS02612RTWR (U13) to 24904 out of TE.DbLib/IF, MPZ1608S221ATA00 (L2,L3,L4) to 22718 out of TE.DbLib/L_1608_0603
    [ETH-PHY.SchDoc, SD_Card.SchDoc, UltraZOhm_CarrierBoard.PrjPcb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]
2020-11-18 changed SiT8008 25MHz (U3) SIT8008BI-73-18S-25.000000G to 27228 out of TE.DbLib/CLK, 100k R_0603 (R134) to 22467 out of TE.DbLib/R_1608_0603
    [ETH-PHY.SchDoc, Power_Supply_2.SchDoc, UltraZOhm_CarrierBoard.PrjPcb]
2020-11-18 changed 200k R_0603 resistors to 29980 out of TE.DbLib/R_1608_0603, 412k R_0603 (R145) to 26111 out of TE.DbLib/A_R_1608_0603, BAT46W (D4) to 29999 out of TE.DbLib/DIODE
    [Digital_Interface.SchDoc, LevelShifting.SchDoc, LevelShiftingExtGPIO.SchDoc, LevelShiftingXMOD.SchDoc, Power_Supply_2.SchDoc, UltraZOhm_CarrierBoard.PrjPcb]
2020-11-18 changed STPS340-Y (D17) to 26110 out of TE.DbLib/A_DIODE
    [Power_Supply_2.SchDoc, UltraZOhm_CarrierBoard.PrjPcb]
2020-11-18 changed dnp R_0603 resistors (all from R_1608_0603): 0R to 21491 10k to 21492 100k to 22467 220R to 22324 20k to 22538 200k to 29980 dnf unchangend?
    [Digital_Interface.SchDoc, J2.SchDoc, LevelShifting.SchDoc, LevelShiftingXMOD.SchDoc, Pilot_Line.SchDoc, Power_Supply_1.SchDoc, Power_Supply_2.SchDoc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]
2020-11-18 added excel chart of the components missing in the TrenzLib
    [MissingComponents_CarrierBoard_TrenzLib.xlsx]
2020-11-18 changed DIP Switch SW1,SW2,SW3 (GDH04STR04) to 23417 out of TE.DbLib/PB_SW
    [J2.SchDoc, UltraZOhm_CarrierBoard.PrjPcb]
2020-11-24 added bom with missing components
    [MissingComponents_CarrierBoard_TrenzLib.xlsx]
2020-11-24 missing parts BOM
    [BOM_MissingComponents.xlsx]
2020-11-24 comments nach diskussion mit andreas und simon
    [BOM_MissingComponents.xlsx]
2020-11-24 changed 150060RS75000 LED_RED_0603 to 28261 out of TE.DbLib/LED, 150060GS75000 LED_GREEN_0603 to 28262 out of TE.DbLib/LED, SMBJ30A TVS_Unidir_SMB (D23) to 27476 out of TE.DbLib/DIODE, BAT203 to 2676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
    [BOM_MissingComponents_in_process_Simon.xlsx, J2.SchDoc, Power_Supply_1.SchDoc, Power_Supply_2.SchDoc, Power_Supply_Input.SchDoc, UltraZOhm_CarrierBoard.PrjPcb, isoCAN.SchDoc, isoGPIO.SchDoc]
2020-11-24 changed R_0805_PTC-Fuse (R170A-H) to 28044 out of TE.DbLib/ FUSE, 62R R_0603 resistors to 23134 out of TE.DbLib/R_1005_0402
    [BOM_MissingComponents_in_process_Simon.xlsx, External_IO_Protection.SchDoc, UltraZOhm_CarrierBoard.PrjPcb, isoCAN.SchDoc]
2020-11-24 changed ESDCAN01-BLY (D5) to 27400 out of TE.DbLib/DIODE, ATP108-TL-H ONSC_PMOS_ATP108 (T8,T11) to 27247 out of TE.DbLib/TRANSISTOR
    [BOM_MissingComponents_in_process_Simon.xlsx, Power_Supply_Input.SchDoc, UltraZOhm_CarrierBoard.PrjPcb, isoCAN.SchDoc]
2020-11-24 changed 51R R_0603_Array_4R (EXB-38V5103V) to 22843 out of TE.DbLib/R_NET
    [BOM_MissingComponents_in_process_Simon.xlsx, Digital_Interface.SchDoc, UltraZOhm_CarrierBoard.PrjPcb]
2020-11-24 massenmail an trenz versendet mit allen samtec steckern als SMD
    [BOM_MissingComponents.xlsx, MissingComponents_CarrierBoard_TrenzLib.xlsx, PleaseAdd_Email.xlsx]
2020-11-24 changed 1k91 R_0603 (R94) to 28021 out of TE.DbLib/R_1005_0402
    [BOM_MissingComponents_in_process_Simon.xlsx, Power_Supply_1.SchDoc, Power_Supply_2.SchDoc, Power_Supply_Input.SchDoc]
2020-11-24 changed 74AHC1G146W,125 (U5A,U5B) to 25648 out of TE.DbLib/LOGIC, SiT8924,4MHz (U1) to 29707 out of TE.DbLib/CLK
    [BOM_MissingComponents_in_process_Simon.xlsx, Digital_Interface.SchDoc, UltraZOhm_CarrierBoard.PrjPcb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]
2020-11-24 - changed 7499110123 (X4) to 30726 out of TE.DbLib/CON_IO - adjusted voltage rating of caps for power supply: 220uF (C48,C49,C58,C59,C68,C69,C86) to 23410 out of TE.DbLib/C_2012_0805 47uF (C92,C93) t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
    [BOM_MissingComponents_in_process_Simon.xlsx, ETH-PHY.SchDoc, Power_Supply_1.SchDoc, Power_Supply_2.SchDoc, UltraZOhm_CarrierBoard.PrjPcb]
2020-11-25 adjusted votlage rating of caps for power supply: 10uF 35V to 24685 (10uF 50V) out of TE.DbLib/C_3216_1206 (changed PCB layout of power supply)
    [BOM_MissingComponents_in_process_Simon.xlsx, Power_Supply_1.SchDoc, Power_Supply_2.SchDoc]
2020-11-25 adjusted voltage rating of caps for power supply: 470nF 50V to 23659 (470nF 6.3V but 0402) out of TE.DbLib/C_1005_0402
    [Power_Supply_1.SchDoc, UltraZOhm_CarrierBoard.PrjPcb]
2020-11-27 updated missing parts list, checked some part changes, documents in the xsl
    [BOM_MissingComponents.xlsx, PleaseAdd_Email.xlsx]
2020-12-01 removed 3.2mm mounting holes (MH1-MH6)
    [CarrierBoard_TopSheet.SchDoc, UltraZOhm_CarrierBoard.PrjPcb]
2020-12-01 removed MR connection to the JTAG adapter X8 changed pull-up voltage on R202 to 3.3V added MR testpoint
    [J2.SchDoc, UltraZOhm_CarrierBoard.PrjPcb, XMOD.SchDoc]
2020-12-01 changed SN74LVC1G17DCKR (U5) to 23582 out of TE.DbLib/LOGIC (SN74LVC1G14DRL)
    [Digital_Interface.SchDoc]
2020-12-01 replaced output capacitors of DCDC converters in Power_Supply_1.SchDoc -> replaced 2x22uF and 1x220uF with 3x100uF -> used 23116 out of TE.DbLib/C_3216_1206
    [Power_Supply_1.SchDoc, Power_Supply_2.SchDoc]
2020-12-01 - changed resistors at FB of U12: 10k R_0603 to 25052 out of TE.DbLib/R_1005_0402 1k91 R_0402 to 21514 out of TE.DbLib/R_1608_0603 - changed 470nF of power supply (C47,C57,C67) to 25476 out of TE.DbL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
    [Power_Supply_1.SchDoc, UltraZOhm_CarrierBoard.PrjPcb]
2020-12-05 Used TPS54260 twice to generate both 1.8V rails: - added Power_Supply.SchDoc as a lower-level schematic of Power_Supply_2 - copied component placement in rooms (PCB-layout) - changed polygons (VIN, 5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
    [Power_Supply.SchDoc, Power_Supply_2.SchDoc, UltraZOhm_CarrierBoard.PrjPcb]
2020-12-12 Used TPS54260 twice to generate both 1.8V rails: - took Vin out of the module - renamed lower-level schematic to "Power_Supply_1V8" - integrated the power module twice - without repeat
    [CarrierBoard_TopSheet.SchDoc, Power_Supply.SchDoc, Power_Supply_1V8.SchDoc, Power_Supply_2.SchDoc, UltraZOhm_CarrierBoard.PrjPcb]
2020-12-12 changed IPL1-103-01-L-D-K (X12) to 30760 (IPL1-103-02-L-D-K) out of TE.DbLib/CON_HEADER IPL1-108-01-L-D-K (X13) to 30764 (IPL1-108-02-L-D-K) out of TE.DbLib/CON_HEADER IPL1-105-01-L-D-K (X14) to 3075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
    [Power_Supply_Input.SchDoc, UltraZOhm_CarrierBoard.PrjPcb, isoCAN.SchDoc, isoGPIO.SchDoc, isoSPI.SchDoc]
2020-12-12 changed IPL1-110-02-L-D-K (X3) to 30765 out of TE.DbLib/CON_HEADER, IPL1-106-02-L-D-K (X10) to 30763 out of TE.DbLib/CON_HEADER, HSEC8-140-01-L-DV-A-BL (X5) to 30758 (HTEC8-140-01-L-DV-K) out of TE.D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
    [Analog_Interface.SchDoc, BOM_MissingComponents_in_process_Simon.xlsx, Board2Board.SchDoc, XMOD.SchDoc]
2020-12-12 changed HSEC8-150-01-L-DV-A-BL (X6) to 30757 (HTEC8-150-01-L-DV-K) out of TE.DbLib/CON_B2B
    [BOM_MissingComponents_in_process_Simon.xlsx, Digital_Interface.SchDoc]
2020-12-12 changed ADUM4401 (U18) to 30781 (ISO7741QDWRQ1) out of TE.DbLib/SPECIAL
    [BOM_MissingComponents_in_process_Simon.xlsx, isoSPI.SchDoc]
2020-12-12 changed ADUM4402 (U24,U26) to 30782 (ISO7742QDWRQ1) out of TE.DbLib/SPECIAL
    [BOM_MissingComponents_in_process_Simon.xlsx, isoGPIO.SchDoc]
2020-12-12 changed MAX14878AWE+ (U6) to 30766 out of TE.DbLib/IF, LMK00105SQ/NOPB (U32) to 30774 out of TE.DbLib/CLK
    [BOM_MissingComponents_in_process_Simon.xlsx, isoCAN.SchDoc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]
2020-12-15 changed SN6505BDBVT (U9,U21,U29) to 30768 out of TE.DbLib/DRIVER, 76039015 (U8,U20,U28) to 30767 out of TE.DbLib/L_TRANS
    [BOM_MissingComponents_in_process_Simon.xlsx, isoCAN.SchDoc, isoGPIO.SchDoc, isoSPI.SchDoc]
2020-12-15 changed NLV74HC32ADTR2G (U15,U16) to 30783 out of TE.DbLib/LOGIC
    [BOM_MissingComponents_in_process_Simon.xlsx, Collective_FAULT_logic.SchDoc]
2020-12-15 changed 0154005.DR Littlefuse_154_Fuse (F1) to 30775 out of TE.DbLib/FUSE, 744235900 (L5) to 30776 out of TE.DbLib/L_SMD
    [BOM_MissingComponents_in_process_Simon.xlsx, Power_Supply_Input.SchDoc, UltraZOhm_CarrierBoard.PrjPcb, isoCAN.SchDoc]
2020-12-15 changed 4k99 R_0603 resistors (R50,R56) to 22754 out of TE.DbLib/R_1005_0402, 150060BS75000 (D12,D24) to 30779 out of TE.DbLib/LED
    [BOM_MissingComponents_in_process_Simon.xlsx, DiagLEDs.SchDoc, ETH-PHY.SchDoc, Power_Supply_1.SchDoc]
2020-12-15 changed LA4128V-75TN100E (U4) to 30780 out of TE.DbLib/PROG_LOGIC
    [BOM_MissingComponents_in_process_Simon.xlsx, Digital_Interface.SchDoc, UltraZOhm_CarrierBoard.PrjPcb]
2020-12-15 - changed TXS0108EQPWRQ1 (U14,U25,U30) to 30791 out of TE.DbLib/A_IF - removed R149, R225, R211 (level shifter)
    [BOM_MissingComponents_in_process_Simon.xlsx, LevelShifting.SchDoc, LevelShiftingExtGPIO.SchDoc, LevelShiftingXMOD.SchDoc]
2020-12-15 - changed BZX84C15 (D22) to 29229 (MMSZ5242BT1G) out of TE.DbLib/DIODE - changed C121 10uF 35V to 10uF 50V (1206) - changed C72 47uF 16V to 47uF 6.3V (0805) - changed C1 22uF 25V to 100uF 6.3V (1206)
    [BOM_MissingComponents_in_process_Simon.xlsx, J3.SchDoc, Power_Supply_1.SchDoc, Power_Supply_Input.SchDoc, SD_Card.SchDoc]
2020-12-15 - changed R127, R164 to 26473 (6k98 R_0603) out of TE.DbLib/R_1608_0603 and R126, R161 to 22655 (12k R_0603) out of TE.DbLib/R_1608_0603 to get ratio of 1.7 (3V3) - changed R81 to 26473 (6k98 R_0603)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
    [BOM_MissingComponents_in_process_Simon.xlsx, UltraZOhm_CarrierBoard.PrjPcb, isoCAN.SchDoc, isoGPIO.SchDoc, isoSPI.SchDoc]
2020-12-15 changed CDSOD323-T03SC (8x D21) to twice 29054 (CPDA10R3V3U-HF) out of TE.DbLib/DIODE TVS Array on lower-level schematic and as sheet entry in isoGPIO.SchDoc
    [4_Channel_TVS.SchDoc, BOM_MissingComponents_in_process_Simon.xlsx, External_IO_Protection.SchDoc, UltraZOhm_CarrierBoard.PrjPcb, isoGPIO.SchDoc]
2020-12-16 - changed IPL1-108-02-L-D-K (X11) to 30764 out of TE.DbLib/CON_HEADER - changed R176, R177 (4k99 R_0603) to 22754 out of TE.DbLib/R_1005_0402 - repositioned designators
    [LevelShifting.SchDoc, UltraZOhm_CarrierBoard.PrjPcb, XMOD.SchDoc]
2020-12-16 - removed all teardrops from the design and afterwards added teardrops to all objects again - updated source library from D4 (TE.DbLib/DIODE -> TE.DbLib/A_DIODE)
    [Digital_Interface.SchDoc, UltraZOhm_CarrierBoard.PrjPcb]
2020-12-16 changed all R_Config resistors (0R, 10k, dnp): - replaced dnp 3way jumpers with 30792 out of TE.DbLib/PCB - replaced assembled 3way jumpers with two resistors defined by assembly variant
    [ETH-PHY.SchDoc, J2.SchDoc, LevelShifting.SchDoc, LevelShiftingExtGPIO.SchDoc, LevelShiftingXMOD.SchDoc, Power_Supply_2.SchDoc, SD_Card.SchDoc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]
2020-12-16 changed IPL1-104-01-L-S-K (X7) to 30790 out of TE.DbLib/CON_HEADER
    [UltraZOhm_CarrierBoard.PrjPcb, isoCAN.SchDoc]
2020-12-16 - updated U15, U16 (30783) because of wrong package/footprint - updated all teardrops
    [Collective_FAULT_logic.SchDoc, UltraZOhm_CarrierBoard.PrjPcb]
2020-12-17 simulation files of power supply input protection circuit
2020-12-26 updated documentation of move to trenz lib, after discussion with simon and andreas on 17.12.2020
    [BOM_MissingComponents.xlsx, BOM_MissingComponents_in_process_Simon.xlsx]
2020-12-26 fixed PG_Module port. close Issue #73
    [Power_Supply_2.SchDoc, UltraZOhm_CarrierBoard.PrjPcb]
2020-12-29 added simulation files to PowerSupply_Input_v4
2020-12-30 updated footprints from trenz lib for components J1-J4, U2, U10-U12, D23, X1,3,4,8,10,11,16
    [J2.SchDoc]
2020-12-30 switched to trenz footprints for parts T1-T10, U3, U13, U17, U20, U31, R75 close Issue #70 and close Issue #71
    [Digital_Interface.SchDoc, J2.SchDoc, Power_Supply_2.SchDoc, UltraZOhm_CarrierBoard.PrjPcb]
2020-12-31 cleaned up M13 and M14 layers (assembly top and bottom), also updated all values from trenz lib
    [4_Channel_TVS.SchDoc, Analog_Interface.SchDoc, Board2Board.SchDoc, Collective_FAULT_logic.SchDoc, DiagLEDs.SchDoc, Digital_Interface.SchDoc, ETH-PHY.SchDoc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]
2021-01-01 - reviewed all schematics and fixed several small bugs in the Variants - rerouted entire Power_Supply_Input and adjusted design rules to get desired pin connection - changed R176, R177 to 0603 packag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
    [Board2Board.SchDoc, CarrierBoard_TopSheet.SchDoc, Digital_Interface.SchDoc, ETH-PHY.SchDoc, External_IO_Protection.SchDoc, J1.SchDoc, J2.SchDoc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]
2021-01-01 fixed layer naming and output jobe file to create correct assembly drawing.
2021-01-02 - added and placed fiducials - place R181 - added SATA schematic, harness and and routed it on bottom - implemented 0.3mm clearance rule from trenz and rerouted isolated SPI - ISO CAN and SPI needs s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
    [Board2Board.SchDoc, CarrierBoard_TopSheet.SchDoc, ETH-PHY.SchDoc, J2.SchDoc, J3.SchDoc, LevelShifting.SchDoc, SATA.schdoc, UltraZOhm_CarrierBoard.PrjPcb]
2021-01-03 reshuffeled iso CAN and resolved all clearance violations, expect for the ones for testpoints and 3 pad jumpers pads without assembly.
2021-01-04 bom consolidation
    [External_IO_Protection.SchDoc, LevelShifting.SchDoc, Power_Supply_1.SchDoc, UltraZOhm_CarrierBoard.PrjPcb]
2021-01-04 renamed CAN1,2 to CAN0,1 close Issue #63
    [XMOD.SchDoc]
2021-01-04 added rule of solder mask expansion = 0, as trenz requests.
2021-01-04 updated M15 M16, courtyard layer from PCB library to correctly generate pick&place files
2021-01-04 - teardrops updated - cleaned up drill holes - updated all schematics with the UZ schematic template
    [4_Channel_TVS.SchDoc, Analog_Interface.SchDoc, Block_Diagram.SchDoc, Board2Board.SchDoc, CarrierBoard_TopSheet.SchDoc, Collective_FAULT_logic.SchDoc, DiagLEDs.SchDoc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]
2021-01-07 - removed PS1V8 from JTAG adapter and rerouted it - changed naming convention of MIO pins previously used for USB in J3 - changed naming convention of GT Lanes in J2 - added second SATA connection - 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
    [Board2Board.SchDoc, CarrierBoard_TopSheet.SchDoc, Digital_Interface.SchDoc, J1.SchDoc, J2.SchDoc, J3.SchDoc, SATA.schdoc, UltraZOhm_CarrierBoard.PrjPcb]
2021-01-08 power is shifted to the right
2021-01-10 moved power supplies to the right.
2021-01-11 working on phy sgmii rerouted Vin
    [Board2Board.SchDoc, CarrierBoard_TopSheet.SchDoc, ETH-PHY_SGMII.SchDoc, ETH-PHY_SGMII_TI.SchDoc, J2.SchDoc, LevelShifting.SchDoc, LevelShiftingExtGPIO.SchDoc, LevelShiftingXMOD.SchDoc]
2021-01-11 routing of phy
    [ETH-PHY.SchDoc, ETH-PHY_SGMII.SchDoc, UltraZOhm_CarrierBoard.PrjPcb]
2021-01-13 routed GTH TX0 auf A1 split MDIO from eth_bus
    [Analog_Interface.SchDoc, Board2Board.SchDoc, CarrierBoard_TopSheet.SchDoc, ETH-PHY.SchDoc, ETH-PHY_SGMII.SchDoc, J1.SchDoc, J3.SchDoc, SATA.schdoc]
2021-01-13 GTH schematic to spilt singal in channels 1..3
    [GTH.SchDoc]
2021-01-17 intermediate step for changes requested in issue #80, issue issue #49
    [4_Channel_TVS.SchDoc, Analog_Interface.SchDoc, Block_Diagram.SchDoc, Board2Board.SchDoc, CarrierBoard_TopSheet.SchDoc, DiagLEDs.SchDoc, Digital_Interface.SchDoc, ETH-PHY.SchDoc]
2021-01-19 finished routing front panel connector
    [4_Channel_TVS.SchDoc, Analog_Interface.SchDoc, Board2Board.SchDoc, CarrierBoard_TopSheet.SchDoc, DiagLEDs.SchDoc, Digital_Interface.SchDoc, ETH-PHY.SchDoc, ETH-PHY_SGMII.SchDoc]
2021-01-27 close #42, close #43, close #82, close #83, close #84, close #85, work in progress on issue #6 issue #80
    [4_Channel_TVS.SchDoc, CarrierBoard_TopSheet.SchDoc, ETH-PHY.SchDoc, ETH-PHY_SGMII.SchDoc, External_IO_Protection.SchDoc, FrontPanel.SchDoc, J2.SchDoc, LevelShifting_Isolation.SchDoc]
2021-01-29 added LTspice simulation concerning driving of front panel LEDs
2021-01-29 in the middle of changing the front panel
    [FrontPanel.SchDoc, LED_external.SchDoc, LevelShifting_Isolation.SchDoc, Switch_External.SchDoc, TVS_4Ch_bidirectional.SchDoc, UltraZOhm_CarrierBoard.PrjPcb]
2021-01-31 - added 2 mounting holes for SOM - close issue #6 - shorted pin53 and pin54 on carrier board - close issue #88 - cleaned up drc errors, still some open though
    [4_Channel_TVS_alternative.SchDoc, Analog_Interface.SchDoc, CarrierBoard_TopSheet.SchDoc, External_IO_Protection.SchDoc, FrontPanel.SchDoc, LED_external.SchDoc, LevelShifting_Isolation.SchDoc, TVS_4Ch_bidirectional.SchDoc]
2021-02-01 - updated rules similar to trenz tebf0808 - length matching and keep outs for gtr lanes - repaired drc violations
    [Analog_Interface.SchDoc, ETH-PHY_SGMII.SchDoc, FrontPanel.SchDoc, GTH.SchDoc, J3.SchDoc, UltraZOhm_CarrierBoard.PrjPcb, XMOD.SchDoc]
2021-02-01 - replaced component D8,D9,D13 from Trenz lib - updated schematic and footprints from Trenz lib
    [4_Channel_TVS_alternative.SchDoc, CarrierBoard_TopSheet.SchDoc, ETH-PHY_SGMII.SchDoc, FrontPanel.SchDoc, GTH.SchDoc, J2.SchDoc, LevelShifting.SchDoc, LevelShiftingXMOD.SchDoc]
2021-02-02 pushing only to increase repo size
    [CarrierBoard_TopSheet.SchDoc, UltraZOhm_CarrierBoard.PrjPcb]
2021-02-04 fixed logo and R181, before footprint update from library
    [4_Channel_TVS_alternative.SchDoc, CarrierBoard_TopSheet.SchDoc, ETH-PHY_SGMII.SchDoc, FrontPanel.SchDoc, GTH.SchDoc, J2.SchDoc, LevelShifting.SchDoc, LevelShiftingXMOD.SchDoc]
2021-02-04 updated all footprints from library.
2021-02-08 - added differential vias and stitching caps for mgt lanes, see issue #91 - added optional thevenin termination for mdc on ethernet phy
    [ETH-PHY_SGMII.SchDoc, GTH.SchDoc]
2021-02-09 updated sheet numbering
    [4_Channel_TVS.SchDoc, 4_Channel_TVS_alternative.SchDoc, Analog_Interface.SchDoc, Block_Diagram.SchDoc, Board2Board.SchDoc, CarrierBoard_TopSheet.SchDoc, Collective_FAULT_logic.SchDoc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]
2021-02-12 worked on gth and gtx routing close Issue #91
    [ETH-PHY.SchDoc, ETH-PHY_SGMII.SchDoc, GTH.SchDoc, Power_Supply_1.SchDoc, SATA.schdoc, UltraZOhm_CarrierBoard.PrjPcb, isoSPI.SchDoc]
2021-02-19 - deleted compile masks close issue #99 - deleted comments on trenz part number close issue #100
    [ETH-PHY.SchDoc, SD_Card.SchDoc]
2021-02-19 - added alternative for CLK on CPLD U1 - close issue #96
    [CPLD_Programming.SchDoc]
2021-02-20 - added sata_crossover schematic to cross Rx and Tx, see also issue #94 - turned x17B to route sata_crossover easier - updated sheet count in all schematics
    [4_Channel_TVS.SchDoc, 4_Channel_TVS_alternative.SchDoc, Analog_Interface.SchDoc, Block_Diagram.SchDoc, Board2Board.SchDoc, CarrierBoard_TopSheet.SchDoc, Collective_FAULT_logic.SchDoc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]
2021-02-22 changed naming from SATA to GTR, close issue #94
    [Board2Board.SchDoc, CarrierBoard_TopSheet.SchDoc, GTH.SchDoc, GTR.schdoc, GTR_crossover.schdoc, J1.SchDoc, J2.SchDoc, SATA.schdoc]
2021-02-23 fixed issue with project variants
    [UltraZOhm_CarrierBoard.PrjPcb]
2021-03-01 fixed variants and small comments by andreas (issue #103 and issue #104)
    [ETH-PHY_SGMII.SchDoc, UltraZOhm_CarrierBoard.PrjPcb, isoGPIO.SchDoc]
2021-03-01 based on vadim suggestion, changed variant name with customer supplied parts to "B"
    [UltraZOhm_CarrierBoard.PrjPcb]
2021-03-04 - fixed compiled sheet order - updated components from trenz library
    [4_Channel_TVS.SchDoc, 4_Channel_TVS_alternative.SchDoc, Analog_Interface.SchDoc, Board2Board.SchDoc, CarrierBoard_TopSheet.SchDoc, Collective_FAULT_logic.SchDoc, DiagLEDs.SchDoc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]
2021-03-04 - removed seperate schematic for tvs diodes: close issue #102 - cleaned up routing: close issue #105
    [4_Channel_TVS.SchDoc, 4_Channel_TVS_alternative.SchDoc, FrontPanel.SchDoc, LevelShifting_Isolation.SchDoc, UltraZOhm_CarrierBoard.PrjPcb, isoCAN.SchDoc]
2021-03-04 - updating all footprints from library - close Issue #106 - added teardrops - checked in gerber files to review - added compiled schematic
    [BOM-TEC0194-01.csv, BOM_xlsx.xls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]
2021-03-04 saved entire project
    [UltraZOhm_CarrierBoard.PrjPcb]
2021-03-05 regenerated gerber files, added missing layers and board outline.
    [BOM_xlsx.xls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]
2021-03-06 - adjusted mounting hole template close issue #114 - Top Overlay cosmetic close Issue #110 - fixed Isolation barrier inconsistency: close Issue #112 - regenerated all output files
    [BOM_xlsx.xls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]
2021-03-08 andreas and eyke approved this version of production files, we are ready. :)
    [BOM_xlsx.xls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]
2021-03-11 production files sent to Trenz
    [BOM-TEC0194-01-B.csv, BOM-TEC0194-01.csv, BOM_xlsx-B.xls, BOM_xlsx.xls, PP-TEC0194-01-B.csv, PP-TEC0194-01.csv, UltraZOhm_CarrierBoard.PrjPcb]
2021-04-14 increased spacing around mounting holes and plated the holes as NCAB suggested
    [UltraZOhm_CarrierBoard.PrjPcb]
2021-04-14 added gnd planes on Layer 3 and Layer 4 to equalize copper amount across the pcb
2021-04-14 regenerated output files to fulfill the manufacturing changes of ncab
    [LPC0194-01.GBL, LPC0194-01.GBO, LPC0194-01.GBP, LPC0194-01.GBS, LPC0194-01.GTL, LPC0194-01.GTO, LPC0194-01.GTP, LPC0194-01.GTS]
2021-04-27 Update block diagram and documentation output for UltraZohm website
    [Block_Diagram.SchDoc, ETH-PHY_SGMII.SchDoc, UltraZOhm_CarrierBoard.PrjPcb, XMOD.SchDoc]
2021-08-13 changed R137 to DNP, close Issue #116
    [UltraZOhm_CarrierBoard.PrjPcb]
2021-08-13 added assembly files for TEC0194-01-C, second assembly round of carrier board Rev.04
    [BOM-TEC0194-01-C.csv, BOM_xlsx-C.xls, PP-TEC0194-01-C.csv, UltraZOhm_CarrierBoard.PrjPcb]
2021-08-13 clean up of pdfs for variants added git-lfs attribute
    [BOM_UltraZOhm_CarrierBoard_3v00.xls, BOM_UltraZOhm_CarrierBoard_3v00_AG1.xls, PickPlace_UltraZOhm_CarrierBoard_4v00.csv]
2021-08-13 add pdf for trenz assembly TEC0194-01-C
2021-08-13 UltraZOhm_CarrierBoard.PcbDoc: convert to Git LFS
2021-08-13 UltraZOhm_CarrierBoard.PCBDwf: convert to Git LFS
2021-10-22 created BOM for assembly variant S001, mit neuen Beistellungen
    [BOM-TEC0194-01-S001.csv, BOM_xlsx-S001.xls, PP-TEC0194-01-S001.csv, UltraZOhm_CarrierBoard.PrjPcb, bom_change_s001.xlsx]
2021-10-22 changed to adum parts in trenz library
    [BOM-TEC0194-01-S001.csv, BOM_xlsx-S001.xls, PP-TEC0194-01-S001.csv, UltraZOhm_CarrierBoard.PrjPcb, bom_change_s001.xlsx]
2022-01-12 changes CPLD to to larger version LC4256
    [BOM-TEC0194-01-S001.csv, BOM_xlsx-S001.xls, PP-TEC0194-01-S001.csv, UltraZOhm_CarrierBoard.PrjPcb]
2022-01-30 Testing introduction (End of line) for the Carrier Board
2022-02-02 Change Component TPS54260QDGQRQ1 to TPS54260QDGQR
    [Power_Supply_1V8.SchDoc]
2022-02-02 generated new project output files for Trenz
    [BOM-TEC0194-01-S001.csv, BOM_xlsx-S001.xlsx, PP-TEC0194-01-S001.csv]
2022-02-03 Set SN6505 to DNP for Trenz production
    [BOM-TEC0194-01-S001.csv, BOM_xlsx-S001.xlsx, PP-TEC0194-01-S001.csv, UltraZOhm_CarrierBoard.PrjPcb]
2022-03-14 fixed pick and place file generation in altium 21
    [PP-TEC0194-01-S001.csv, UltraZOhm_CarrierBoard.PcbDoc]
2022-04-07 added quick fix soldering manual for PHY reset issue
2022-08-04 - added pdfs and bom for fixing missing resistors in rev04 -s001 order - added list of beistellungen and approximate costs
    [BOM_xlsx-S001_additional_costs.xlsx, BOM_xlsx-S001_fix.xlsx]
2022-08-04 added costs of jlc order
    [BOM_xlsx-S001_additional_costs.xlsx]
2022-10-26 initial draft of BOM for S002 sent to Trenz
    [BOM-TEC0194-01-S002.csv, UltraZOhm_CarrierBoard.PrjPcb]
2023-01-03 production files for TEC0194-01-S003
    [BOM-TEC0194-01-S002.csv, BOM-TEC0194-01-S003.csv, BOM_xlsx-S003.xlsx, PP-TEC0194-01-S003.csv, UltraZOhm_CarrierBoard.PrjPcb]
2023-01-19 update gitattributes to avoid case sensitive conflicts
2023-01-19 change names to uz_carrier_board - step 1
    [UltraZOhm_CarrierBoard.PrjPcb]
2023-01-19 cleaning repo
    - remove production files
    - rename project to uz_carrierboard
    [BOM_MissingComponents.xlsx, BOM_MissingComponents_in_process_Simon.xlsx, PleaseAdd_Email.xlsx, UZ_CarrierBoard.PrjPcb, UltraZOhm_CarrierBoard.PcbDoc, UltraZOhm_CarrierBoard.PrjPcb]
2024-06-03 unify Ethernet sheets (no actual change)
    [ETH-PHY.SchDoc, ETH-PHY_SGMII.SchDoc]
2024-06-03 add Ethernet resets
    [CarrierBoard_TopSheet.SchDoc, ETH-PHY.SchDoc, ETH-PHY_SGMII.SchDoc]
2024-06-03 move Ethernet connector(s) to dedicated sheet and introduce BASE-T harness
    [ETH-PHY.SchDoc, ETH-PHY_SGMII.SchDoc, ETH-RJ45.SchDoc]
2024-06-03 split Ethernet resets
    [ETH-PHY_SGMII.SchDoc]
2024-06-12 add isoJTAG
    [CarrierBoard_TopSheet.SchDoc, Signal_Distribution.SchDoc, UZ_CarrierBoard.PrjPcb, XMOD.SchDoc, isoJTAG-FTDI.SchDoc, isoJTAG-Isolation.SchDoc, isoJTAG.SchDoc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]
2024-06-13 unify UARTs and I²Cs, and map UART1 to USB-JTAG as well
    [Board2Board.SchDoc, CarrierBoard_TopSheet.SchDoc, J2.SchDoc, J3.SchDoc, Signal_Distribution.SchDoc, XMOD.SchDoc]
2024-06-18 bom für rev05 für winsource anfrage
    [BOM_Rev05_Preliminary_Anfrage_WinSource.xlsx]
2024-06-19 add WS BOM 10x
    [BOM_Rev05_Preliminary_Anfrage_WinSource_10x.xlsx]
2024-06-27 changed J4 Connector
    [J4.SchDoc]
2024-07-01 move on-SoM I²C to PS I²C1
    [Board2Board.SchDoc, CarrierBoard_TopSheet.SchDoc]
2024-07-01 split adapter card/CPLD I²Cs and add mux to PS I²C0
    [CarrierBoard_TopSheet.SchDoc, I2C0_Mux.SchDoc, Signal_Distribution.SchDoc]
2024-07-05 swap ISO674[12]s of isoJTAG to F versions
    [isoJTAG-Isolation.SchDoc]
2024-07-08 first d+u before updating schematics
2024-07-08 [JLC] swap J1,J4 SOM Connectors
    [J1.SchDoc, J4.SchDoc]
2024-07-08 [JLC] update board
    [UZ_CarrierBoard.PcbDoc]
2024-07-08 [JLC] swap AnalogInterface
    [Analog_Interface.SchDoc]
2024-07-08 martin und eyke fixed sn6505 variant bug
    [UZ_CarrierBoard.PcbDoc, UZ_CarrierBoard.PrjPcb]
2024-07-09 [JLC] changed D Slot Connector
    [Digital_Interface.SchDoc]
2024-07-09 [JLC] update project
    [UZ_CarrierBoard.PrjPcb]
2024-07-09 [JLC] changed 0R 0603 on whole project
    [Digital_Interface.SchDoc, ETH-PHY.SchDoc, ETH-PHY_SGMII.SchDoc, External_IO_Protection.SchDoc, FrontPanel.SchDoc, J2.SchDoc, J4.SchDoc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]
2024-07-09 [JLC] swap TE0970 Base (X1)
    [CPLD_Programming.SchDoc]
2024-07-09 [JLC]changed X1 again
    [CPLD_Programming.SchDoc]
2024-07-09 [JLC]changed 10k 0603 (76x)
    [Collective_FAULT_logic.SchDoc, DiagLEDs.SchDoc, Digital_Interface.SchDoc, ETH-PHY.SchDoc, ETH-PHY_SGMII.SchDoc, External_IO_Protection.SchDoc, J2.SchDoc, LED_external.SchDoc]
2024-07-09 [JLC]swap U13 and X16 from SD
    [SD_Card.SchDoc]
2024-07-09 [JLC]swap X8
    [XMOD.SchDoc]
2024-07-09 [JLC]swap U7 isocan
    [isoCAN.SchDoc]
2024-07-09 [JLC]swap R80 isocan
    [isoCAN.SchDoc]
2024-07-09 [JLC]swap U19 IsoSPI
    [isoSPI.SchDoc]
2024-07-09 [JLC]swap U27
    [isoGPIO.SchDoc]
2024-07-09 [JLC] changed T11 and T8
    [Power_Supply_Input.SchDoc]
2024-07-09 correct DMP4015SSS-13
    [Power_Supply_Input.SchDoc]
2024-07-10 [JLC]swapped D22 Zener and D23 TVS to unidirectional
    [Power_Supply_Input.SchDoc]
2024-07-10 [JLC]swapped all 47k 0603 and F1 on Power supply input
    [Power_Supply_1.SchDoc, Power_Supply_Input.SchDoc]
2024-07-10 [JLC] changed to 12V Zener Diode and update board
    [Power_Supply_Input.SchDoc, UZ_CarrierBoard.PcbDoc]
2024-07-10 [JLC] changed power supply u10-12 to ti
    [Power_Supply_1.SchDoc]
2024-07-10 [JLC] changed 100k 0603, 20k 0603,1k5 0603, 4k7 0603, 8k06 0402,100R 0603,1k 0603
    [Power_Supply_1.SchDoc, Power_Supply_1V8.SchDoc]
2024-07-10 [JLC] changed LED D10-12
    [Power_Supply_1.SchDoc]
2024-07-10 [JLC] changed to generic resistors except R145
    [Power_Supply_1V8.SchDoc, Power_Supply_2.SchDoc]
2024-07-10 [JLC] changed D's U's and T's of Powersupply
    [Power_Supply_1V8.SchDoc, Power_Supply_2.SchDoc]
2024-07-10 [JLC]swap X17 Sata to lib
    [GTR.schdoc]
2024-07-10 [JLC]swap R145+R90 (non generic, also mentioned in DbLib)
    [Power_Supply_1.SchDoc, Power_Supply_1V8.SchDoc]
2024-07-10 [JLC] revert changes in SchDoc Sites that shouldn't be changed
    [ETH-PHY.SchDoc, ETH-PHY_SGMII.SchDoc, J2.SchDoc, XMOD.SchDoc]
2024-07-10 [JLC] previous last commit, save whole project
    [UZ_CarrierBoard.PrjPcb]
2024-07-10 [JLC] change schematics back to master, now ready for martin to be merged
    [CPLD_Programming.SchDoc]
2024-07-10 solve footprint errors with Trenz parts
    [UZ_CarrierBoard.PcbDoc, UZ_CarrierBoard.PrjPcb]
2024-07-11 [JLC] test to change parameter from database successfull
    [J1.SchDoc, J4.SchDoc]
2024-07-11 add pull-ups to I²C0 mux
    [I2C0_Mux.SchDoc, UZ_CarrierBoard.PrjPcb]
2024-07-12 move Ethernet LED resistors to connector
    [ETH-PHY.SchDoc, ETH-PHY_SGMII.SchDoc, ETH-RJ45.SchDoc]
2024-07-12 move Ethernet connector(s) to toplevel
    [CarrierBoard_TopSheet.SchDoc, ETH-PHY.SchDoc, ETH-PHY_SGMII.SchDoc]
2024-07-12 move entire SGMII Ethernet and connector of RGMII Ethernet to frontpanel
    [CarrierBoard_TopSheet.SchDoc, ETH-PHY_SGMII.SchDoc, ETH-RJ45.SchDoc, UZ_CarrierBoard.PrjPcb]
2024-07-12 rename harness (from ETH to ETH_RGMII)
    [Board2Board.SchDoc, CarrierBoard_TopSheet.SchDoc, ETH-PHY.SchDoc, J3.SchDoc]
2024-07-12 fix harness sheet entry
    [CarrierBoard_TopSheet.SchDoc]
2024-07-19 add outputjob file for JLC production
    [UZ_CarrierBoard.PrjPcb]
2024-07-21 lock GTR.Harness for connector-free net naming and add frontpanel connector (with preliminary pinning from uz_frontpanel_main)
    [Board2Board.SchDoc, CarrierBoard_TopSheet.SchDoc, GTR.schdoc, GTR_crossover.schdoc, J2.SchDoc, UZ_CarrierBoard.PrjPcb, XMOD.SchDoc, XMOD_Frontpanel.SchDoc]
2024-07-22 rotate (180°) D17[AB], rotate (180°) and move (2.515/-0.977+0.6) D22, and rotate (-90°) R90; fix of design rules(?) w.r.t. mounting hole clearance and repour still pending...
    [UZ_CarrierBoard.PcbDoc]
2024-07-31 fix design rules; repour still pending...
    [UZ_CarrierBoard.PcbDoc]
2024-07-31 t+g+a -> back at 152 drc errors (and therewith in line with master aka 67b56a421f380ed79787d4d26142fcd42fc96b30)
    [UZ_CarrierBoard.PcbDoc]
2024-08-02 [JLC] changed capacitors (to both generic and JLC-selected ones)
    [Collective_FAULT_logic.SchDoc, Digital_Interface.SchDoc, External_IO_Protection.SchDoc, GTH.SchDoc, GTR.schdoc, LevelShifting.SchDoc, Power_Supply_1.SchDoc, Power_Supply_1V8.SchDoc]
2024-08-02 [JLC] update board (incl. t+g+a)
    [UZ_CarrierBoard.PcbDoc]
2024-08-03 prepare for merge with Rev05 (part 1/3: remove parts)
    [Collective_FAULT_logic.SchDoc, FrontPanel.SchDoc, LevelShifting.SchDoc, LevelShiftingXMOD.SchDoc, Rev05MergeRedux--External_IO_Protection.SchDoc, Rev05MergeRedux--LED_external.SchDoc, Rev05MergeRedux--LevelShifting_Isolation.SchDoc, UZ_CarrierBoard.PrjPcb]
2024-08-03 prepare for merge with Rev05 (part 2/3: remove rests)
    [UZ_CarrierBoard.PcbDoc]
2024-08-03 prepare for merge with Rev05 (part 3/3: update polys)
    [UZ_CarrierBoard.PcbDoc]
2024-08-04 fix and update variant Rev05, others unchecked (except for R210 ;))
    [ETH-PHY.SchDoc, I2C0_Mux.SchDoc, UZ_CarrierBoard.PrjPcb]
2024-08-04 bump revision and date
    [UZ_CarrierBoard.PrjPcb]
2024-08-06 switch from CPLD to new Lattice MachXO2 as D-Slot-Controller; set DNPs in variant for EEPROM addressing pull-downs
    [Digital_Interface.SchDoc, UZ_CarrierBoard.PrjPcb]
2024-08-06 add system connections (SPI and DIOs) to D-slot controllers; update I²C ports to Andi's changes (all other ports still pending)
    [CarrierBoard_TopSheet.SchDoc, DIG_S3C_MultiChannelFunnel.SchDoc, S3C.SchDoc, Signal_Distribution.SchDoc, UZ_CarrierBoard.PrjPcb]
2024-08-07 add sheet entry ports of Digital_Interface.SchDoc
    [Digital_Interface.SchDoc, Signal_Distribution.SchDoc]
2024-08-14 add stock for parts
    [BOM_Rev05_Stock_30x.xlsx, BOM_Rev05_WinSource_30x.xlsx]
2024-08-14 adapt to new layer stack (profiles still OOD) and reroute D-slots signals while preparing for MGTs
    [UZ_CarrierBoard.PcbDoc]
2024-08-14 remove Rev04 PS-GTR circuitry (SGMII Ethernet, 2x SATA) while preparing for MGTs
    [UZ_CarrierBoard.PcbDoc]
2024-08-15 reassign layers, make L7 a ground plane/poly and adapt VCCO routing while preparing for MGTs
    [UZ_CarrierBoard.PcbDoc]
2024-08-16 push queued schematic changes to board and position X1 (towards frontpanel_main)
    [CarrierBoard_TopSheet.SchDoc, I2C0_Mux.SchDoc, J3.SchDoc, UZ_CarrierBoard.PcbDoc, UZ_CarrierBoard.PrjPcb, XMOD.SchDoc, XMOD_Frontpanel.SchDoc, isoJTAG-FTDI.SchDoc]
2024-08-19 make Power_Supply_1V8 parametric (and rename to Power_Supply_TPS54260) while adding S³C supply, make unprotected supply input available and add basic monitoring
    [CarrierBoard_TopSheet.SchDoc, Power_Supply_1V8.SchDoc, Power_Supply_2.SchDoc, Power_Supply_Input.SchDoc, Power_Supply_TPS54260.SchDoc, S3C.SchDoc, S3C_SupplyAndMonitoring.SchDoc, UZ_CarrierBoard.PrjPcb]
2024-08-20 draw safety block diagram
    [Block_Diagram_Safety.SchDoc, UZ_CarrierBoard.PrjPcb]
2024-08-21 document all Power_Supply_TPS54260 instances
    [Power_Supply_2.SchDoc, S3C_SupplyAndMonitoring.SchDoc]
2024-08-22 add further monitoring sources
    [S3C_SupplyAndMonitoring.SchDoc]
2024-08-23 set Slot Controller resistor-array designator to Rev04 compatible designators; change Testpoint lib; update safety diagram
    [Block_Diagram_Safety.SchDoc, Digital_Interface.SchDoc, UZ_CarrierBoard.PrjPcb]
2024-08-23 fix "multiple top level documents" error (caused by Block_Diagram_Safety.SchDoc)
    [CarrierBoard_TopSheet.SchDoc]
2024-08-23 generalize power monitoring of VIN
    [Power_Monitoring_TPS3803.SchDoc, S3C.SchDoc, S3C_SupplyAndMonitoring.SchDoc, UZ_CarrierBoard.PrjPcb]
2024-08-26 add S³C
    [S3C.SchDoc, S3C_IOs1V8.SchDoc, S3C_IOs3V3.SchDoc, UZ_CarrierBoard.PrjPcb]
2024-08-26 remove former external CPLD clock and distribution chip
    [Signal_Distribution.SchDoc, UZ_CarrierBoard.PcbDoc, UZ_CarrierBoard.PrjPcb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]
2024-08-26 placement of System Controller surrounding parts
    [Digital_Interface.SchDoc, UZ_CarrierBoard.PcbDoc]
2024-08-27 add JTAG multiplexing
    [CarrierBoard_TopSheet.SchDoc, S3C.SchDoc, S3C_IOs3V3.SchDoc, S3C_MuxJTAG.SchDoc, UZ_CarrierBoard.PrjPcb]
2024-08-28 placement of System Controller surrounding parts [commit identical to AG's currently-missing 06856e03010c32b7e662252b030a39b178ec9ba5]
    [Digital_Interface.SchDoc, UZ_CarrierBoard.PcbDoc]
2024-08-28 update S³C-to-D connctions based on Block_Diagram_Safety and extend concept docs
    [Block_Diagram_Safety.SchDoc, DIG_S3C_MultiChannelFunnel.SchDoc, S3C.SchDoc, Signal_Distribution.SchDoc]
2024-08-28 small fixes (sheet template, project includes)
    [Block_Diagram_Safety.SchDoc]
2024-08-31 route isoUSB (JTAGs and UARTs), simplify power distribution (below SoM) and make room on L4/5 for primarily-horizontal/vertical (below-SoM) routing
    [UZ_CarrierBoard.PcbDoc, isoJTAG-Isolation.SchDoc]
2024-09-01 rewire GND @ J1 (making room on L8 for horizontal below-SoM routing) and prepare for B64_T[0-3] breakout (to S³C)
    [UZ_CarrierBoard.PcbDoc]
2024-09-02 [JLC] changed oscillator of RGMII Ethernet
    [ETH-PHY.SchDoc]
2024-09-05 insert CPLD JTAG harness
    [Digital_Interface.SchDoc, Signal_Distribution.SchDoc]
2024-09-05 remove PILOT_LINE chain through digital sockets
    [Pilot_Line.SchDoc, Signal_Distribution.SchDoc, UZ_CarrierBoard.PcbDoc, UZ_CarrierBoard.PrjPcb]
2024-09-05 Add high-side switch for VIN supply of adapter cards
    [Power_Protection_DigitalAndAnalogInterfaces.SchDoc]
2024-09-05 placement and routing of slot high-side switch
    [Digital_Interface.SchDoc, Power_Protection_DigitalAndAnalogInterfaces.SchDoc, Signal_Distribution.SchDoc, UZ_CarrierBoard.PcbDoc, UZ_CarrierBoard.PrjPcb]
2024-09-06 local routing D-Slot controller
    [Digital_Interface.SchDoc, UZ_CarrierBoard.PcbDoc]
2024-09-09 D-Slot controller pinout planning
    [UZ_CarrierBoard.PcbDoc]
2024-09-10 rearrange FPGA pins to D-Slot controller
    [Digital_Interface.SchDoc, UZ_CarrierBoard.PcbDoc]
2024-09-10 finish local routing of D-Slot controller D1
    [Digital_Interface.SchDoc, UZ_CarrierBoard.PcbDoc]
2024-09-10 transfer routing to D2 - D5 via "copy room formats" feature
    [Digital_Interface.SchDoc, UZ_CarrierBoard.PcbDoc]
2024-09-10 routing of VIN high-side switch protection at all D-Slots
    [Digital_Interface.SchDoc, UZ_CarrierBoard.PcbDoc, UZ_CarrierBoard.PrjPcb]
2024-09-10 remove already-disabled schematic sheets (isoCAN/GPIO/SPI, level shifting and old FP), remap MIOs, add CPLD-SPI logic, I²C subsystems, level shifting for the new frontpanel's user interface, thermal 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
    [Board2Board.SchDoc, CarrierBoard_TopSheet.SchDoc, DiagLEDs.SchDoc, ETH-PHY.SchDoc, FrontPanel.SchDoc, I2C0_Mux.SchDoc, I2C_Subsystems.SchDoc, J2.SchDoc]
2024-09-10 clean up nets and reactivate air wires
    [UZ_CarrierBoard.PcbDoc]
2024-09-12 update parts to pull database fixes
    [ETH-PHY.SchDoc, Power_Supply_TPS54260.SchDoc]
2024-09-12 add high-side switch to A slots as well (complements 5327beea1afd211846eae97bf5e8b169325dbc78, "schematically")
    [Analog_Interface.SchDoc, Signal_Distribution.SchDoc]
2024-09-12 optimize towards BoM
    [Analog_Interface.SchDoc, Collective_FAULT_logic.SchDoc, J1.SchDoc, J2.SchDoc, J3.SchDoc, Power_Supply_1.SchDoc, SD_Card.SchDoc]
2024-09-12 update parts to pull metadata from database, replace J2 and J3, set non-part and non-DB components "no BoM", set X15 "DNP" and fix incorrect variant definitions for U4[A-E] (from 544edd64bebbccc5473d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
    [Analog_Interface.SchDoc, CarrierBoard_TopSheet.SchDoc, J1.SchDoc, J2.SchDoc, J3.SchDoc, J4.SchDoc, Power_Supply_Input.SchDoc, UZ_CarrierBoard.PrjPcb]
2024-09-12 resolve DNP-FIXMEs (1/2)
    [J2.SchDoc, Power_Protection_DigitalAndAnalogInterfaces.SchDoc, UZ_CarrierBoard.PrjPcb]
2024-09-13 fix debug LEDs
    [DiagLEDs.SchDoc]
2024-09-13 match symbol rotation to board netlist while preparing for d+u
    [ETH-PHY.SchDoc, Power_Supply_1.SchDoc, Power_Supply_TPS54260.SchDoc, SD_Card.SchDoc]
2024-09-13 push post-merge part updates to board (partial d+u), fix resulting orientation and clearance issues, and manually swap the (nine) non-matching packages (X14, D1-3, D24[A-D] and D25)
    [UZ_CarrierBoard.PcbDoc]
2024-09-16 add remaining schematic changes (pending from pre merge)
    [Analog_Interface.SchDoc, Board2Board.SchDoc, CarrierBoard_TopSheet.SchDoc, Collective_FAULT_logic.SchDoc, Digital_Interface.SchDoc, J2.SchDoc, J3.SchDoc, LevelShifting.SchDoc]
2024-09-16 optimize S3C supply
    [Power_Supply_2.SchDoc, Power_Supply_Input.SchDoc, S3C_SupplyAndMonitoring.SchDoc]
2024-09-16 swap and move X14, move U2 et al., update D100 parametrization and add BP markers (all while preparing for d+u)
    [UZ_CarrierBoard.PcbDoc]
2024-09-16 t+a (while preparing for d+u)
    [DiagLEDs.SchDoc, I2C_Subsystems.SchDoc, J2_RefClkAndRTC.SchDoc, Power_Monitoring_TPS3803.SchDoc, Power_Supply_1.SchDoc, Power_Supply_Input.SchDoc, S3C.SchDoc, S3C_IOs1V8.SchDoc]
2024-09-16 resolve DNP-FIXMEs (2/2)
    [Power_Supply_Input.SchDoc, S3C_IOs1V8.SchDoc, Signal_Distribution.SchDoc, UZ_CarrierBoard.PrjPcb, XMOD_Thermal.SchDoc]
2024-09-29 S³C and frontpanel connected, board routed except for D slot ground
    Details:
    - reroute SoM configurations signals
    - route GTRs of SoM
    - length-match GTRs
    - optimize RGMII
    - move 1V8_PER
    - move SD card
    - add I²C subsystem
    - add voltage monitoring
    - add labels for SoM cfg. DIPs (bottom overlay)
    - route frontpanel-driven GTR refclock (cf. MZ)
    - add RTC battery (w/ LDO)
    - route CPLD communication
    - route Ethernet MDI to FP
    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
    [Analog_Interface.SchDoc, Board2Board.SchDoc, CarrierBoard_TopSheet.SchDoc, Digital_Interface.SchDoc, ETH-PHY.SchDoc, GTH.SchDoc, I2C_Subsystems.SchDoc, J2_RefClkAndRTC.SchDoc]
2024-09-30 fix D-slot CPLD pins (14+16) and route D slot (CPLD) ground
    [UZ_CarrierBoard.PcbDoc]
2024-09-30 fix 965 compiler errors ("Duplicate Net Names Wire [...]") caused by pin-incompatible component overrides for U4[A-E] in variants S00[1-3]
    [UZ_CarrierBoard.PrjPcb]
2024-09-30 unify via tenting based on feedback from JLC
    [UZ_CarrierBoard.PcbDoc]
2024-09-30 enable generation of Gerber Board Profile (suffix .GM)
2024-10-05 fix component/database issues (missing solder mask definitions for C126-137 and incorrect footprints for D4, U28A and U28B)
    [J2_RefClkAndRTC.SchDoc, Power_Monitoring_TPS3803.SchDoc, S3C_SupplyAndMonitoring.SchDoc, UZ_CarrierBoard.PcbDoc]
2024-10-05 move S1, R15, R128, R129 and R136 (and reroute accordingly)
    [UZ_CarrierBoard.PcbDoc, UZ_CarrierBoard.PrjPcb]
2024-10-05 remove shared signals of analog slots and add legacy "P54" ADC clock via S³C
    [Analog_Interface.SchDoc, S3C_IOs3V3.SchDoc, Signal_Distribution.SchDoc, UZ_CarrierBoard.PcbDoc]
2024-10-11 import @EykeAufderheide's part mapping for UZgen workflow (columns E and G only)
    [BOM_JLC-UZ_CarrierBoard(Rev05)-UZgenPartsMap.csv]
2024-10-11 fix and resolve part map (change voltage of C_0603_2.2nF)
    [BOM_JLC-UZ_CarrierBoard(Rev05)-UZgenPartsMap.csv]
2024-10-11 resolve generic LEDs to finalize part map (as used in production)
    [BOM_JLC-UZ_CarrierBoard(Rev05)-UZgenPartsMap.csv]
2024-10-14 fix age-old "unconnected line" errors (caused by wires in block diagram)
    [Block_Diagram.SchDoc]
2024-10-14 update block diagram to modified signal routing and newly added features
    [Block_Diagram.SchDoc]
2024-10-15 extend block diagram
    [Block_Diagram_Safety.SchDoc]
2024-10-16 moved lower mounting holes +0.25mm y, set distance between upper and lower mounting holes to 122.5mm y, moved X1 +0.24mm y and reconnected all wires, also moved some nearby Vias accordingly. Hopefull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
    [UZ_CarrierBoard.PcbDoc]
2024-10-20 move X1-surrounding vias, tracks, cut-outs and parts (sync to 6fcc8a67c1389249343ba55ca46ab5026fe4fefa), reassign and move S1, move Ethernet (while preparing for GTH breakout), add GND vias, unify ad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
    [Analog_Interface.SchDoc, Digital_Interface.SchDoc, S3C.SchDoc, S3C_IOs1V8.SchDoc, S3C_IOs3V3.SchDoc, Signal_Distribution.SchDoc, UZ_CarrierBoard.PcbDoc, UZ_CarrierBoard.PrjPcb]
2024-12-06 route shared fault of A PPs to S³C, add 12V supply for fan outputs, rename PP instances, add backpanels for external GTH connectivity, add (x1) GTH connectivity to slots A[2-3] as well, replace exist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
    [Analog_Interface.SchDoc, BOM_JLC-UZ_CarrierBoard(Rev05)-UZgenPartsMap.csv, BOM_JLC-UZ_CarrierBoard(Rev05)-UZgenResolved.csv, Backpanel.SchDoc, Backpanel_GigIO.SchDoc, Backpanel_SwapMGT4.SchDoc, Block_Diagram.SchDoc, Board2Board.SchDoc]
2024-12-09 rename sheets
    [Analog_Interface.SchDoc, Backpanel_GigIO.SchDoc, Block_Diagram.SchDoc, Board2Board.SchDoc, CarrierBoard_TopSheet.SchDoc, Digital_Interface.SchDoc, ETH-PHY.SchDoc, Frontpanel.SchDoc]
2024-12-09 assign sheet metadata
    [Backpanel.SchDoc, Backpanel_GigIO.SchDoc, Backpanel_SwapMGT4.SchDoc, Block_Diagram_Safety.SchDoc, DIG_S3C_MultiChannelFunnel.SchDoc, Frontpanel.SchDoc, I2C0_Mux.SchDoc, I2C_Subsystems.SchDoc]
2024-12-09 update sheet metadata (after renumbering)
    [Analog_Interface.SchDoc, Backpanel.SchDoc, Backpanel_GigIO.SchDoc, Backpanel_SwapMGT4.SchDoc, Block_Diagram.SchDoc, Block_Diagram_Safety.SchDoc, CarrierBoard_TopSheet.SchDoc, DIG_S3C_MultiChannelFunnel.SchDoc]
2024-12-15 final schematic (PDF)
    [BOM_Rev05_Preliminary_Anfrage_WinSource.xlsx, BOM_Rev05_Preliminary_Anfrage_WinSource_10x.xlsx, BOM_Rev05_Stock_30x.xlsx, BOM_Rev05_WinSource_30x.xlsx, UZ_CarrierBoard.PrjPcb]
2024-12-15 remove old/invalid and rename current variant(s)
    [BOM_JLC-UZ_CarrierBoard(Rev05Batch00)-UZgenPartsMap.csv, BOM_JLC-UZ_CarrierBoard(Rev05Batch00)-UZgenResolved.csv, UZ_CarrierBoard.PrjPcb]
2025-02-26 parameterize R145, externalize R203[ABD] and remove R203C
    [Power_Supply_2.SchDoc, Power_Supply_TPS54260.SchDoc, S3C_SupplyAndMonitoring.SchDoc, Thermal.SchDoc, UZ_CarrierBoard.PrjPcb]
2025-03-12 move Power_Supply_TPS54260.SchDoc to altium_subsheets: (9db13111d212a5d2e7638154d522cda6653ae0aa)
    [Power_Supply_TPS54260.SchDoc, UZ_CarrierBoard.PrjPcb]
2025-03-14 rename sheet( instance)s
    [UZ_CarrierBoard.PrjPcb, User_Connectors.SchDoc, isoDebug-FTDI.SchDoc, isoDebug-Isolation.SchDoc, isoDebug.SchDoc, isoJTAG.SchDoc]
2025-03-14 rename isoDebug supply nets
    [Frontpanel.SchDoc, isoDebug-FTDI.SchDoc, isoDebug-Isolation.SchDoc, isoDebug.SchDoc]
2025-03-19 rename parts while preparing for (partial) move to altium_subsheets
    [S3C_MuxJTAG.SchDoc, Thermal.SchDoc, UZ_CarrierBoard.PrjPcb, isoDebug-FTDI.SchDoc, isoDebug-Isolation.SchDoc, isoDebug.SchDoc]
2025-03-20 add (and use) power ports while preparing for move to altium_subsheets
    [S3C.SchDoc, S3C_MuxJTAG.SchDoc, Thermal.SchDoc, User_Connectors.SchDoc]
2025-03-20 optimize BoM (Cs)
    [ETH-PHY.SchDoc, J2_RefClkAndRTC.SchDoc, S3C_IOs1V8.SchDoc, Thermal.SchDoc, isoDebug-FTDI.SchDoc, isoDebug.SchDoc]
2025-03-21 optimize BoM (Rs)
    [ETH-PHY.SchDoc, Power_Supply_1.SchDoc, S3C_IOs1V8.SchDoc, Signal_Distribution.SchDoc, UZ_CarrierBoard.PrjPcb, isoDebug-FTDI.SchDoc, isoDebug-Isolation.SchDoc]
2025-03-21 rename nets (supply rails of Ethernet PHY)
    [ETH-PHY.SchDoc]
2025-03-21 move Power_Monitoring_TPS3803.SchDoc, S3C_MuxJTAG.SchDoc, Thermal.SchDoc, isoDebug-FTDI.SchDoc, and isoDebug.SchDoc to altium_subsheets: (b2a920affeff164b522424c97a5b500335c8cbd1)
    [Power_Monitoring_TPS3803.SchDoc, S3C_MuxJTAG.SchDoc, Thermal.SchDoc, UZ_CarrierBoard.PrjPcb, isoDebug-FTDI.SchDoc, isoDebug.SchDoc]
2025-05-08 unify Cs
    [Power_Supply_1.SchDoc, Power_Supply_Input.SchDoc]
2025-05-13 simplify parametrization
    [Power_Protection_VIN.SchDoc, Power_Supply_2.SchDoc, S3C_SupplyAndMonitoring.SchDoc, User_Connectors.SchDoc]
2025-07-07 sync to Rev03 of the I²C/SSD/S²C extension board for Rev04 carriers
    [Frontpanel.SchDoc, Power_Supply_2.SchDoc, S3C.SchDoc, S3C_SupplyAndMonitoring.SchDoc, UZ_CarrierBoard.PrjPcb, User_Connectors.SchDoc]
2025-07-09 optimize schematic
    [Analog_Interface.SchDoc, Backpanel_GigIO.SchDoc, Block_Diagram.SchDoc, Block_Diagram_Safety.SchDoc, CarrierBoard_TopSheet.SchDoc, Digital_Interface.SchDoc, GTH.SchDoc, I2C0_Mux.SchDoc]
2025-07-15 rename and split power/rail protection to include 3V3 and 5V (1/2)
    [Analog_Interface.SchDoc, Backpanel_GigIO.SchDoc, Digital_Interface.SchDoc, Rail_Protection_AD.SchDoc, Rail_Protection_BP.SchDoc, UZ_CarrierBoard.PrjPcb]
2025-07-15 extend rail protection (of slots only) to include 3V3 and 5V (2/2)
    [Analog_Interface.SchDoc, Backpanel.SchDoc, Backpanel_GigIO.SchDoc, CarrierBoard_TopSheet.SchDoc, Digital_Interface.SchDoc, Rail_Protection_AD.SchDoc, Rail_Protection_BP.SchDoc, S3C.SchDoc]
2025-07-17 extend rail protection (of slots only) for shutdown over I²C
    [Analog_Interface.SchDoc, CarrierBoard_TopSheet.SchDoc, Digital_Interface.SchDoc, Rail_Protection_AD.SchDoc, Rail_Shutdown_AD.SchDoc, Signal_Distribution.SchDoc, UZ_CarrierBoard.PrjPcb]
2025-07-18 add (in-Rev05-missing) pull-up Rs to the S³C's secondary I²C ("user bus" channel 5/7) and a (DNP-d) pin header for the spare I²C (7/7)
    [I2C_Subsystems.SchDoc, UZ_CarrierBoard.PrjPcb]
2025-07-18 add clock buffer for legacy "P54" ADC clock (analog slots) via S³C
    [ANL_P54_Buffer.SchDoc, Analog_Interface.SchDoc, Signal_Distribution.SchDoc, UZ_CarrierBoard.PrjPcb]
2025-07-21 replace D4/D5[A-H]
    [J2_RefClkAndRTC.SchDoc, Rail_Protection_AD.SchDoc]
2025-07-22 optimize BoM ([CR]s) and schematic, rename classes and rooms, and add TP
    [CarrierBoard_TopSheet.SchDoc, ETH-PHY.SchDoc, Frontpanel.SchDoc, J2_RefClkAndRTC.SchDoc, Power_Supply_1.SchDoc, Power_Supply_2.SchDoc, Power_Supply_Input.SchDoc, S3C_FrontpanelInterface.SchDoc]
2025-07-23 incorporate manufacturing feedback (1/2)
    [Rail_Shutdown_AD.SchDoc]
2025-07-23 incorporate manufacturing feedback (2/2)
    [Power_Supply_Input.SchDoc, S3C_SupplyAndMonitoring.SchDoc]
2025-07-24 swap (overlay) serial, update (project and board) to Rev06, and add part map for UZgen workflow (as used in production)
    [BOM_JLC-UZ_CarrierBoard(Rev06Batch00)-UZgenPartsMap.csv, CarrierBoard_TopSheet.SchDoc, UZ_CarrierBoard.PcbDoc, UZ_CarrierBoard.PrjPcb]
2025-07-30 (re)set and inherit metadata, respectively (for schematic)
    [Analog_Interface.SchDoc, Backpanel.SchDoc, Backpanel_GigIO.SchDoc, Backpanel_SwapMGT4.SchDoc, Block_Diagram.SchDoc, Block_Diagram_Safety.SchDoc, CarrierBoard_TopSheet.SchDoc, DIG_S3C_MultiChannelFunnel.SchDoc]
2025-08-23 add output files (as used in production)
    [BOM_JLC-UZ_CarrierBoard(Rev06Batch00)-UZgenResolved.csv, Pick Place for UZ_CarrierBoard(Rev06Batch00).csv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]
